pekeppp/xunjicar-speed45/6a52b6358da415270c09f10d88b06ae2.jpg

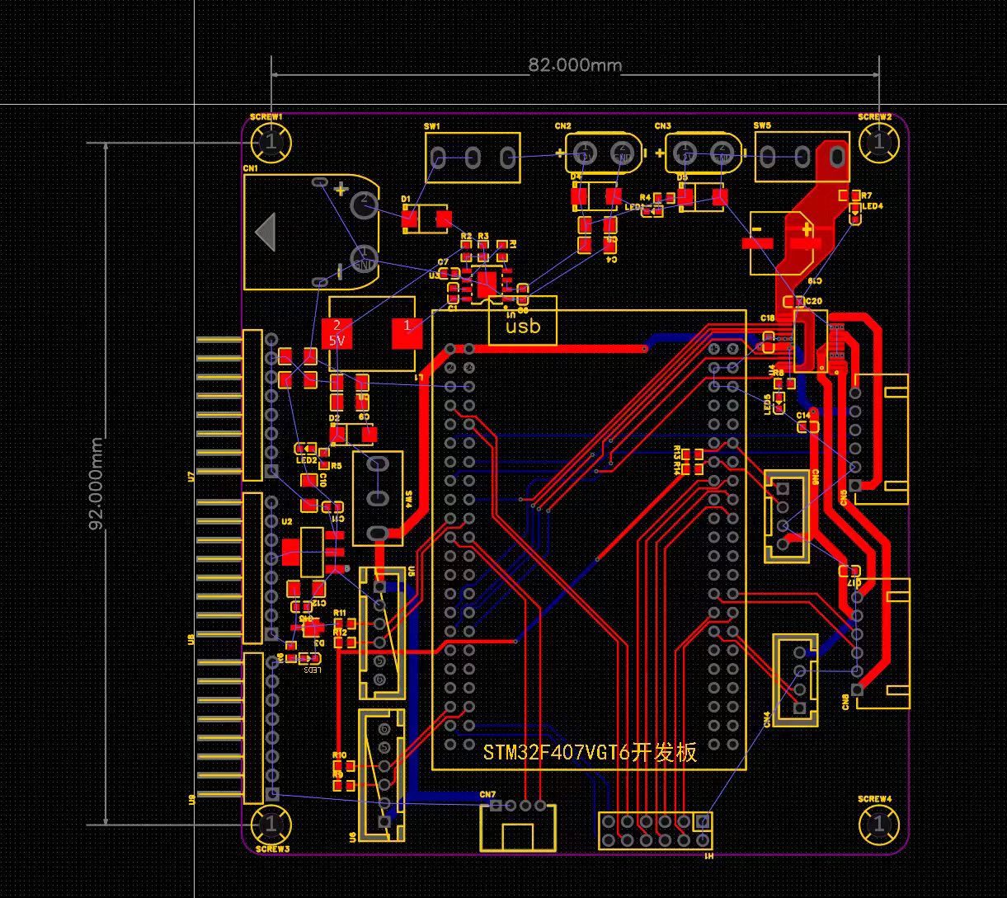
6a52b6358da415270c09f10d88b06ae2.jpg
