pekeppp/xunjicar-speed45/烧录工具与路径说明.md

# 烧录工具与路径说明

> 回答一个问题：**"正常烧录不都要用专门的 programmer 软件吗？这里到底调了哪个软件？什么路径？怎么烧进去的？"**

---

## 一、最核心的一句话

**这里用的 programmer 软件就是 OpenOCD。**

它就是一个正规的、开源的烧录/调试软件（和 STM32CubeProgrammer、Keil 的 Download 按钮是同一类东西），
只是它没有图形界面，靠命令行参数干活。**不是"没有 programmer"，而是"programmer 是命令行版的"。**

```
你双击 3-烧录固件.cmd
        ↓
  3-烧录固件.cmd
        ↓  调用
  tools\flash.ps1                     ← 组装参数的"胶水"脚本
        ↓  调用
  C:\Users\darre\.platformio\packages\tool-openocd\bin\openocd.exe   ★ 真正的 programmer
        ↓  USB 通信
  ST-Link V2 硬件
        ↓  SWD 两根线（SWCLK / SWDIO）
  STM32F407 芯片内部 Flash
```

---

## 二、软件路径：它是怎么被找到的

`tools\flash.ps1` 第 42~71 行，按 **3 个优先级** 找 OpenOCD：

| 优先级 | 查找位置 | 本机结果 |
|---|---|---|
| 1 | 系统 `PATH` 环境变量里的 `openocd` | 没找到 |
| 2 | `C:\Users\darre\.platformio\packages\tool-openocd\`（递归搜 `openocd.exe`） | ✅ **命中** |
| 3 | `C:\Users\darre\AppData\Local\stm32cube\bundles\openocd\` | 没装 |

**本机实际使用的路径：**

```
可执行文件：C:\Users\darre\.platformio\packages\tool-openocd\bin\openocd.exe
脚本目录　：C:\Users\darre\.platformio\packages\tool-openocd\openocd\scripts\
版本　　　：xPack Open On-Chip Debugger 0.12.0+dev-02228-ge5888bda3-dirty
```

脚本目录也是**每一层往上找**出来的（第 60~71 行）：从 `openocd.exe` 所在目录开始往上爬最多 4 层，
看哪层存在 `openocd\scripts\target\stm32f4x.cfg` 或 `scripts\target\stm32f4x.cfg`。

> 这两个文件夹都在 **你的用户目录**下，不在工程里，也不在 C 盘全局。
> 所以换一台电脑，要么重装这两个包，要么把整个 `.platformio` 文件夹拷过去。

---

## 三、真正执行的命令（逐字拆解）

`flash.ps1` 最终拼出来的命令行就是这一条：

```powershell
& "C:\Users\darre\.platformio\packages\tool-openocd\bin\openocd.exe" `
  -s "C:\Users\darre\.platformio\packages\tool-openocd\openocd\scripts" `
  -f interface/stlink.cfg `
  -f target/stm32f4x.cfg `
  -c "adapter speed 1000" `
  -c "program C:/Users/darre/Desktop/competition/xunjicar/xunjicar/XunjiCar/XunjiCar/build/out/XunjiCar.hex verify reset exit"
```

### 每个参数干什么

| 参数 | 含义 | 对应代码行 |
|---|---|---|
| `-s <目录>` | 告诉 OpenOCD 去哪找 `.cfg` 配置文件 | `flash.ps1:96` |
| `-f interface/stlink.cfg` | **用哪种调试器**：ST-Link（里面写死了 USB VID/PID `0x0483:0x3748` 等一长串，插上是哪个型号自动认） | `flash.ps1:97` |
| `-f target/stm32f4x.cfg` | **目标芯片是谁**：STM32F4 系列（声明 flash bank、期望 IDCODE `0x2ba01477`、借 SRAM `0x20000000` 32KB 当 work area） | `flash.ps1:98` |
| `-c "adapter speed 1000"` | SWD 时钟 1000 kHz。**它是运行时覆盖** —— `stm32f4x.cfg` 里默认写的是 2000，加 `-Speed 500` 就变成 500 | `flash.ps1:99` |
| `-c "program … verify reset exit"` | 核心动作：烧 → 校验 → 复位 → 退出 | `flash.ps1:108` |

### 三个模式的区别（第 102~110 行）

```powershell
# 默认（3-烧录固件.cmd）：直接烧
-c "program <hex> verify reset exit"

# -Check（2-检查STLink连接.cmd）：只连接，认出芯片就退出，不写任何东西
-c "init" -c "targets" -c "exit"

# -Erase：先全片擦除再烧
-c "init" -c "reset halt" -c "stm32f4x mass_erase 0"
-c "program <hex> verify reset exit"
```

### 烧哪个文件（第 28 行）

默认烧 `XunjiCar\XunjiCar\build\out\XunjiCar.hex`。
第 90 行有一个关键细节：**把路径里的 `\` 全部换成 `/`** ——
因为 OpenOCD 内部是 Tcl 解释器，反斜杠在 Tcl 里是转义符，带 `\` 的 Windows 路径会被吃掉。

---

## 四、为什么不用 STM32CubeProgrammer / Keil 也能烧

这是最容易困惑的地方。答案是：

> **烧 Flash 这件事，标准做法不止一种。任何能说 SWD 协议的程序都能烧，CubeProgrammer 只是 ST 官方做的一个。**

OpenOCD 自带 **ST-Link 驱动**（`interface/stlink.cfg` 里第一句 `adapter driver st-link`），
它通过 **libusb/WinUSB 直接和 ST-Link 硬件对话**，完全绕开 ST 的驱动和软件栈。

| 方案 | 谁做的 | 要不要装 | 本项目 |
|---|---|---|---|
| **OpenOCD** | 开源社区（xPack 打包） | 一个文件夹，解压即用 | ✅ **在用** |
| STM32CubeProgrammer | ST 官方，带图形界面 | 要装，几百 MB | ❌ 本机没装 |
| Keil MDK 的 Download | Keil 内置 | 要装 Keil + 建工程 | ❌ 用不上（本工程没有 .uvprojx） |
| pyocd | ARM 开源 | `pip install pyocd` | ❌ 手册 §13 有一处提到它，是早期写法，**现在不用了** |

---

## 五、OpenOCD 到底怎么把数据写进 Flash 的

**关键点：写入动作不是 OpenOCD 干的，是 STM32 自己干的。**

```
1. OpenOCD halt 内核
      ↓ 通过 SWD 读写调试寄存器（DHCSR），让 Cortex-M4 停止取指

2. OpenOCD 擦除目标扇区
      ↓ 通过 AHB-AP 直接操作 Flash 控制器寄存器（FLASH_KEYR / FLASH_CR / FLASH_SR）

3. OpenOCD 把一段"Flash 编程算法"下载到 SRAM 0x20000000
      ↓ 这就是 target/stm32f4x.cfg 里 -work-area-phys 0x20000000 -work-area-size 0x8000 的用途

4. 让内核执行这段算法，算法自己去逐字写 Flash 并等 FLASH_SR.BSY 清零
      ↓ （STM32F4 内部 Flash 只能 1→0，所以必须先擦成 0xFF 再写）

5. OpenOCD 回读比对 → 打印 ** Verified OK **
      ↓ flash.ps1 第 134 行就是靠 grep 这个字符串判断成功的

6. reset：释放复位，内核从 0x08000000 重新取指
      ↓ [0x08000000] = 栈顶 MSP，[0x08000004] = Reset_Handler
      ↓ Reset_Handler 设 SP、拷 .data、清 .bss、进 main()
```

芯片地址布局来自链接脚本 `STM32F407VGTx_FLASH.ld`：

| 区域 | 起始地址 | 大小 |
|---|---|---|
| FLASH | `0x08000000` | 1024 KB |
| RAM | `0x20000000` | 128 KB |
| CCMRAM | `0x10000000` | 64 KB |

`XunjiCar.hex` 第一行就能验证这套约定：

```
:020000040800F2              ← 扩展线性地址 = 0x0800（基址 0x08000000）
:100000000000022071750008…   ← 前 4 字节 0x20020000 = 栈顶
                                后 4 字节 0x08007571 = Reset_Handler 地址
:040000050800757109          ← 入口点 = 0x08007571
```

---

## 六、为什么这 4 根线就够了

ST-Link 是个 **USB ↔ SWD 协议转换器**，它自己不是 programmer，只是个"翻译官"：

| ST-Link | 开发板 | 作用 |
|---|---|---|
| SWDIO | PA13 | 双向数据线（板上丝印可能写 `DIO`） |
| SWCLK | PA14 | 时钟线（板上丝印可能写 `CLK`） |
| GND | GND | **必须共地**，否则什么都收不到 |
| 3.3V | 3V3 | 电平参考（VTref），ST-Link 靠它确认目标电压；**不是给板子供电** |

**PA13/PA14 是芯片的 SWD 复用功能，上电默认就是 SWD 模式，且工程代码从没把它们配成普通 IO，所以永远可用。**

> ⚠️ 板上那组排针丝印是 `BT0 3V3 GND DIO CLK`。
> **BT0 = BOOT0，一根线都不要接！** 拉高会进 ST 出厂 Bootloader，你烧的程序就不跑了。

---

## 七、换个软件/换台电脑怎么办

### 换成别的 programmer

```powershell
# 用 STM32CubeProgrammer（本机没装）
STM32_Programmer_CLI.exe -c port=SWD -w XunjiCar.hex -v -rst

# 用 pyocd
pyocd flash -t stm32f407vetx XunjiCar.hex

# 用 Keil：需要先建工程，不推荐
```

注意 `XunjiCar.bin` 是**纯二进制、不带地址**，给串口 ISP 用时必须由工具手动指定起始地址 `0x08000000`；
`XunjiCar.hex` 自带地址字段，随便哪个工具都能直接用。

### 换台电脑要装什么

```powershell
# 1) ARM 编译器（约 200 MB）
python -m platformio pkg install --global --tool platformio/toolchain-gccarmnoneeabi

# 2) OpenOCD（就是本项目的 programmer）
python -m platformio pkg install --global --tool platformio/tool-openocd

# 3) 看数据的串口脚本需要 Python 3
python --version
```

装完先验证：

```powershell
# 应该打印 0.12.0 之类的版本号
C:\Users\<你的用户名>\.platformio\packages\tool-openocd\bin\openocd.exe --version
```

### 也可以不用脚本、手敲原生命令

```powershell
$ocd = "$env:USERPROFILE\.platformio\packages\tool-openocd\bin\openocd.exe"
$sc  = "$env:USERPROFILE\.platformio\packages\tool-openocd\openocd\scripts"

# 只连接、认芯片、列目标
& $ocd -s $sc -f interface/stlink.cfg -f target/stm32f4x.cfg -c "adapter speed 1000" -c "init" -c "targets" -c "exit"

# 真正烧录（路径记得用正斜杠）
& $ocd -s $sc -f interface/stlink.cfg -f target/stm32f4x.cfg -c "adapter speed 1000" `
       -c "program C:/Users/darre/Desktop/competition/xunjicar/xunjicar/XunjiCar/XunjiCar/build/out/XunjiCar.hex verify reset exit"
```

---

## 八、路径/工具相关故障速查

| 报错 | 真实原因 | 处理 |
|---|---|---|
| `没找到 OpenOCD` | 上面 3 个查找位置都没命中 | 跑一遍 `python -m platformio pkg install --global --tool platformio/tool-openocd` |
| `找到 OpenOCD 但没找到脚本目录` | `openocd.exe` 找到了但同包的 `scripts\` 丢了 | 重装 `tool-openocd` 包（别只拷 exe） |
| `找不到固件: …XunjiCar.hex` | 还没编译 | 先跑 `1-编译固件.cmd` / `tools\build.ps1` |
| `Error: open failed` | 没认到 ST-Link 硬件 | 换 USB 口；设备管理器确认有 `STLink` 且状态 OK |
| `Error: init mode failed` | 芯片没供电 / SWD 接错 / 线太长 | 板子自己上电；检查 PA13/PA14；降速 `-Speed 500` |
| target not halted | 调试口被别的软件占了 | 关掉 Keil / CubeIDE / CubeProgrammer / 残留的 `openocd.exe` 进程 |
| 写入报错 | 芯片读保护 | 加 `-Erase` 全片擦除后重烧 |
| 烧完没反应 | BT0 被短到 3V3，或没重新上电 | 拔掉 BT0 上的线；拔插一次电源或按复位 |
| **双击 `.cmd` 一闪而过 / 满屏 `'xxx' 不是内部或外部命令`、`系统找不到指定的路径`、`'ershell' 不是内部或外部命令`** | **`.cmd` 被存成了 LF 换行**。cmd.exe 解析 GBK 批处理时按字节数定位行，LF 会让它错行：中文行被整行吃掉、`cd /d "%~dp0"` 失效、`powershell` 前半截被吞（`pow` 没了 → 剩 `ershell`）。元凶是 `.gitattributes` 里全仓库生效的 `* text=auto eol=lf` | 把 `.cmd` 转回 **CRLF + GBK(936) + 无 BOM**；`.gitattributes` 里已有 `*.cmd text eol=crlf` 兜底。一键修复见第十节 |

---

## 九、一页速记

```
programmer 软件 = OpenOCD（命令行版，无图形界面）
路径            = C:\Users\darre\.platformio\packages\tool-openocd\bin\openocd.exe
配置文件目录    = C:\Users\darre\.platformio\packages\tool-openocd\openocd\scripts\
调用者          = tools\flash.ps1（组装命令行）← 3-烧录固件.cmd（双击入口）
固件            = XunjiCar\XunjiCar\build\out\XunjiCar.hex
核心命令        = openocd -f interface/stlink.cfg -f target/stm32f4x.cfg \
                          -c "adapter speed 1000" \
                          -c "program <hex> verify reset exit"
传输链路        = USB → ST-Link V2 → SWD(PA13/PA14) → Cortex-M4 调试口 → 芯片内部 Flash
写入原理        = OpenOCD 把 Flash 编程算法下载进 SRAM，让芯片自己去擦写自己的 Flash
成功标志        = OpenOCD 打印 ** Verified OK ** → 脚本输出"烧录成功，芯片已复位运行。"
```

---

## 十、`.cmd` 换行修复（万一又坏了）

上面那个"一闪而过"的故障根因只有一个：**`.cmd` 是 LF 换行**。
`cmd.exe` 读批处理时按字节数定位行，LF 会让它错行。**这个坑已经复发过一次**，
所以改完 `.cmd` 或从别处拷来工程后，务必跑一遍下面的自检。

在工程根目录执行这一条就能修好（GBK 读进来、CRLF 写回去，内容一个字不改）：

```powershell
$gbk = [System.Text.Encoding]::GetEncoding(936)
Get-ChildItem *.cmd | ForEach-Object {
    $t = $gbk.GetString([System.IO.File]::ReadAllBytes($_.FullName))
    $t = ($t -replace "`r`n","`n") -replace "`n","`r`n"
    [System.IO.File]::WriteAllBytes($_.FullName, $gbk.GetBytes($t))
}
```

自检这四项，缺一个就会坏：

```powershell
$gbk = [System.Text.Encoding]::GetEncoding(936)
Get-ChildItem *.cmd | ForEach-Object {
    $b = [System.IO.File]::ReadAllBytes($_.FullName)
    $s = $gbk.GetString($b)
    $crlf = ([regex]::Matches($s,"`r`n")).Count
    $lf   = ([regex]::Matches($s,"`n")).Count
    "{0}: BOM={1} CRLF={2} bareLF={3} chcp936={4}" -f `
        $_.Name, ($b[0] -eq 0xEF), $crlf, ($lf-$crlf), [bool]($s -match 'chcp 936')
}
```

**四条铁律**（`.cmd` 必须同时满足）：

| 要求 | 原因 |
|---|---|
| 换行 = **CRLF**（`0D 0A`） | LF 会让 cmd.exe 错行，中文行被吃掉 |
| 编码 = **GBK / CP936**，无 BOM | 本机控制台代码页是 936；有 BOM 时首行会变成 `锘?echo off` 报错 |
| 开头要有 `chcp 936 >nul` | 保证中文提示显示正常 |
| 路径不要带空格 | `tools\build.ps1` 的 `-I` 参数拼接不支持空格路径 |

`.gitattributes` 里的 `* text=auto eol=lf` 是**全仓库**生效的，
所以必须靠后面的 `*.cmd text eol=crlf` 显式盖回 CRLF —— 这两行顺序不能反。

---

## 十一、工程被移动/改名后要检查什么

`tools\build.ps1`、`tools\flash.ps1` 和 4 个 `.cmd` 全部用 `%~dp0` / `$MyInvocation` 定位，
**工程挪到哪都能用，不用改**。`.ioc`、`.mxproject`、`.clangd`、`CMakePresets.json`
也都是相对路径，同样不用改。

唯一写死绝对路径的是编辑器配置：

| 文件 | 内容 | 说明 |
|---|---|---|
| `.vscode/settings.json` | `cmake.sourceDirectory` | 已改成 `${workspaceFolder}/XunjiCar/XunjiCar`，**以后再挪也不会坏** |
| `XunjiCar\XunjiCar\.vscode\c_cpp_properties.json` | `${workspaceFolder}/build/Debug/...` | 本来就是相对路径，不用动 |

换路径后建议清一次旧的构建缓存（里面存着绝对路径）：

```powershell
powershell -ExecutionPolicy Bypass -File tools\build.ps1 -Clean
```

另外 `烧录工具与路径说明.md` 第八/九节里作为**示例**出现的 hex 全路径，
换位置后如果和实际不符，按新的工程根替换即可（`tools\flash.ps1` 运行时自己算路径，不受影响）。
