pekeppp/xunjicar-speed45/docs_引脚位置_LQFP100_全图.png

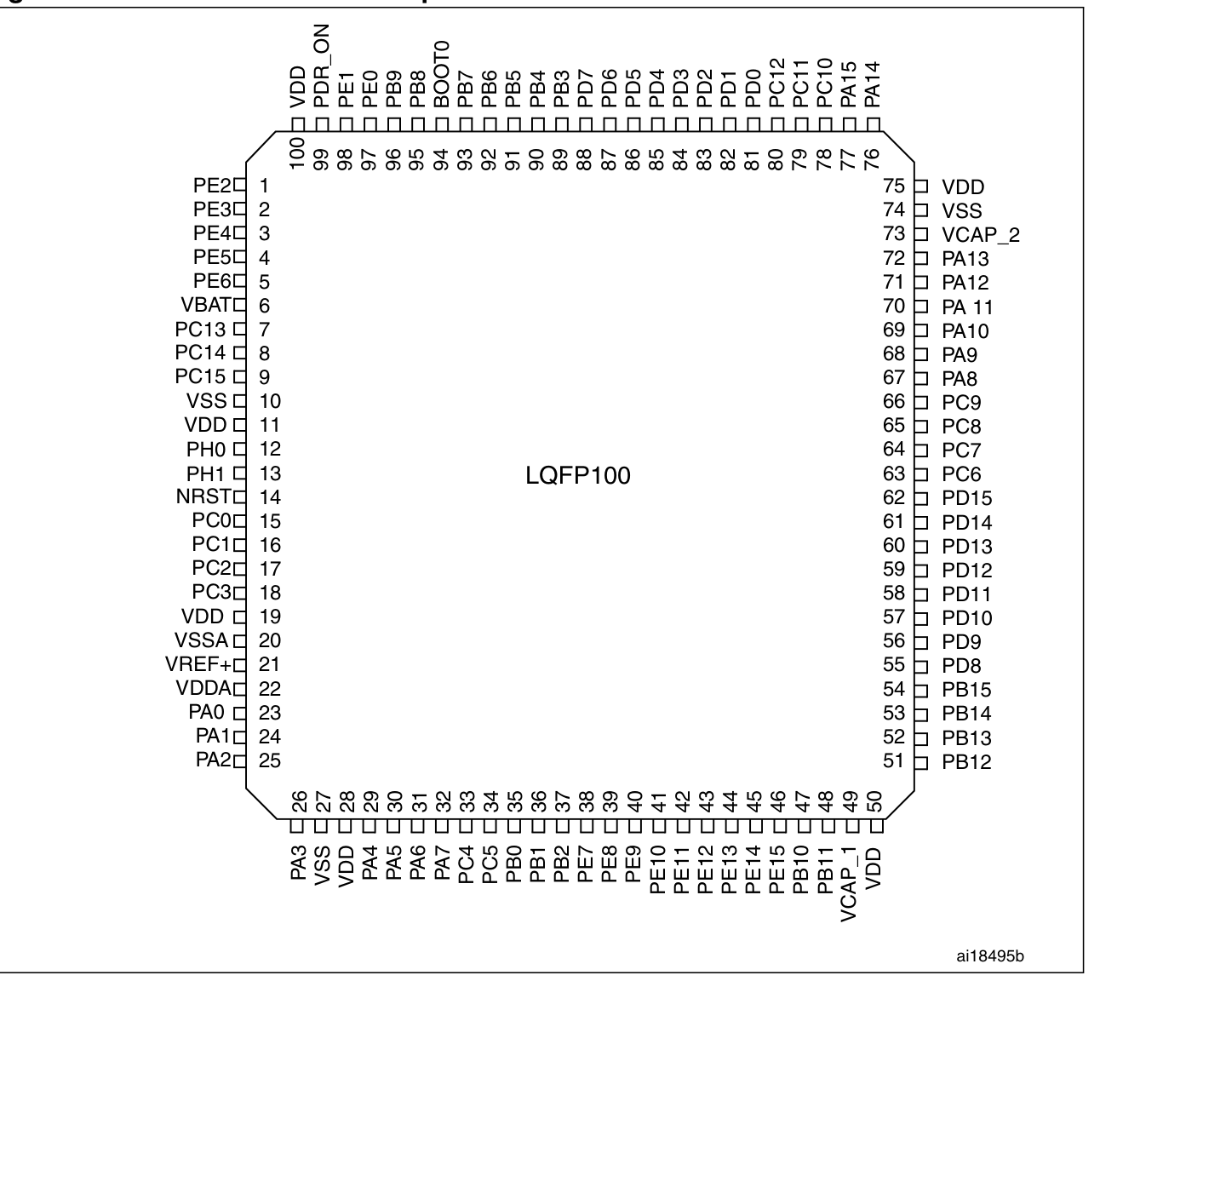
docs_引脚位置_LQFP100_全图.png
