pekeppp/xunjicar-speed45/docs_引脚位置_PA13_PA14_标注.png

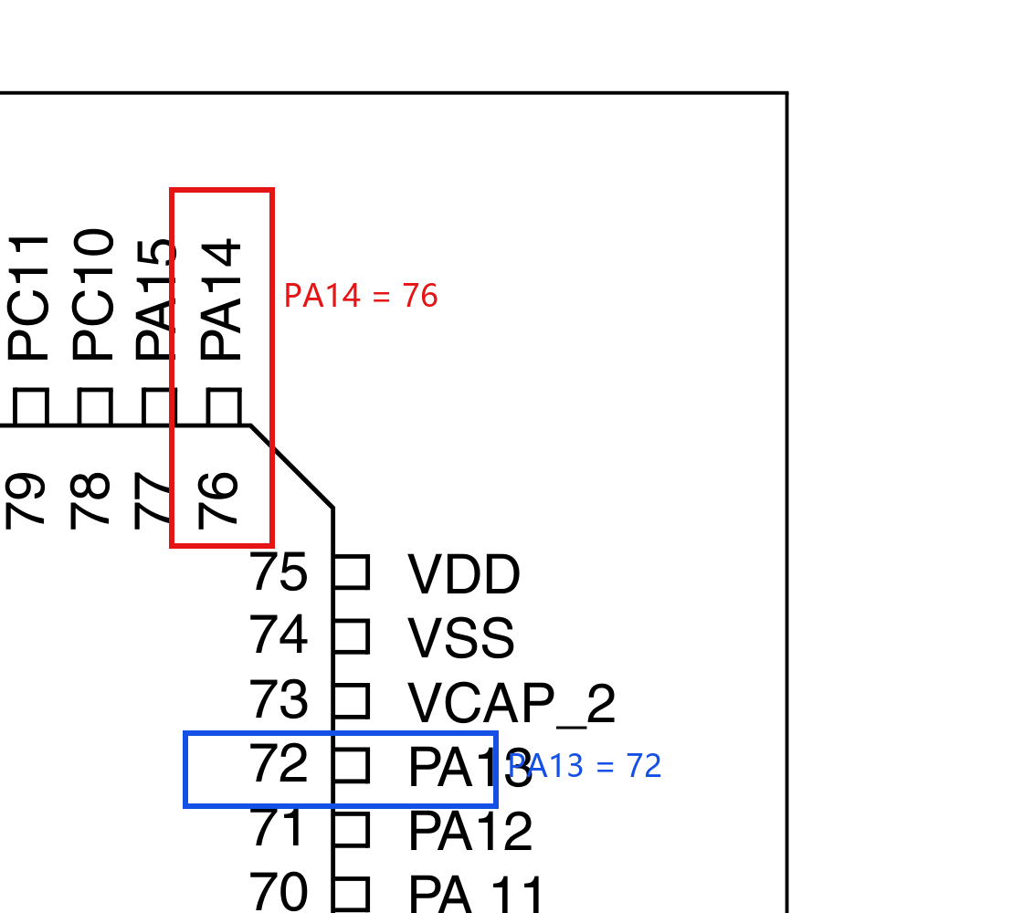
docs_引脚位置_PA13_PA14_标注.png
