pekeppp/xunjicar-speed45/直流电机—MG513XGMR编码器+支架（客户图）.stp

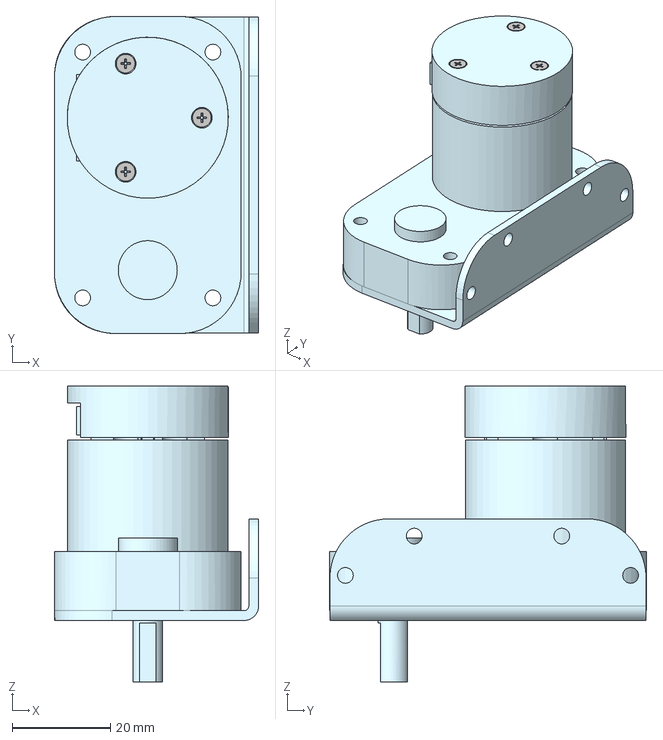
[picture p4: CAD file, 2026-09-30]
直流电机—MG513XGMR编码器+支架（客户图）.stp
41.6 x 64.5 x 60.2 mm
