pekeppp/xunjicar-speed45/直流电机—MG513XGMR编码器+支架+65mm轮子（客户图）.stp

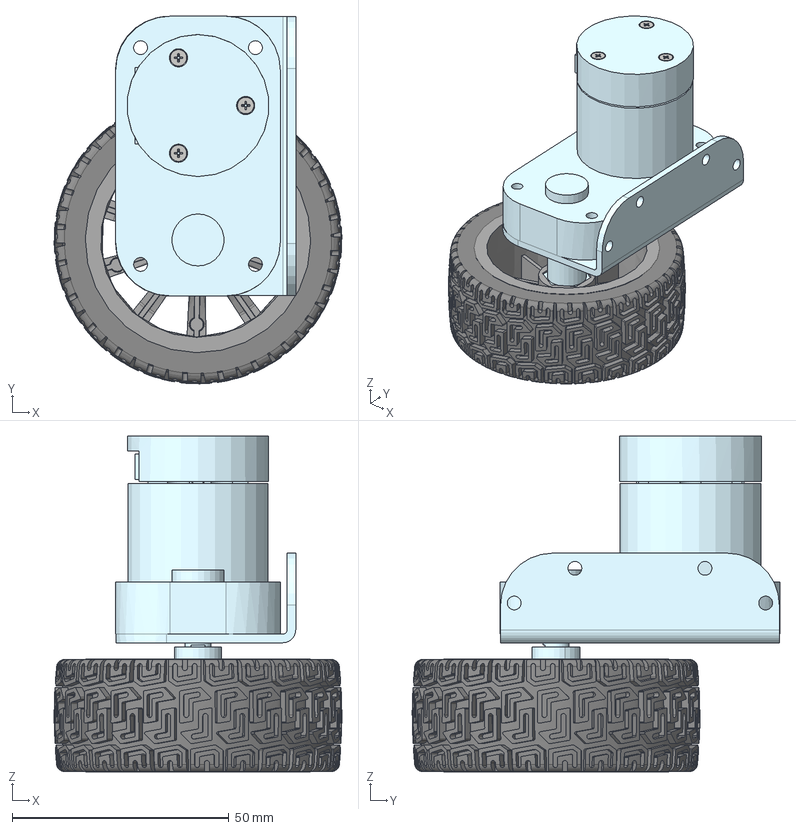
[picture p5: CAD file, 2026-09-30]
直流电机—MG513XGMR编码器+支架+65mm轮子（客户图）.stp
66.4 x 84.8 x 77.5 mm
