pekeppp/xunjicar-speed45/接线与调试手册.md

# 智能小车 接线与调试手册

> 适用硬件：**STM32F407VGT6 开发板（就是图 `6a52b635…jpg` 那块，82×92 mm）** + TB6612FNG 电机驱动
> + 2× MG513 GMR 编码器减速电机 + 8 路 UART 循迹模块 + MPU6050 + 2× VL53L0X
> 适用固件：本仓库 `XunjiCar` 工程（`$CAR` 遥测帧）
> **接线方式：所有模块的杜邦线直接插到这块开发板的长排针上 —— 板子本身就是接线中枢，不需要面包板或转接板。**
> 引脚电平核对结果见第 10 节。

---

## 1. 准备清单

### 硬件
| # | 东西 | 备注 |
|---|---|---|
| 1 | STM32F407 开发板 | 你已组装好的那块 |
| 2 | TB6612FNG 驱动模块 ×1 | 代码按它的引脚命名（AIN1/AIN2/BIN1/BIN2/PWMA/PWMB/STBY）写的 |
| 3 | MG513 编码器电机 ×2 | 6 芯线：M+/M- + VCC/GND/A/B |
| 4 | 8 路红外循迹模块（**串口版**）×1 | 若是 I2C 版或并口版，代码要改，先拍照告诉我 |
| 5 | MPU6050（GY-521）×1 | |
| 6 | VL53L0X 激光测距 ×2 | **必须是 L0X**；买到 VL53L1X 的话寄存器不兼容，代码要换 |
| 7 | USB-TTL 模块 ×1 | CH340 / CP2102 / FT232 都行，**必备**，否则看不到数据 |
| 8 | ST-Link V2 ×1（推荐） | 用 SWD 烧录，不占用 USART1 |
| 9 | 电池 | 2S 锂电 7.4V 或 6 节 AA 电池盒 9V，给电机用 |
| 10 | 5V 降压模块 ≥2A | 从电池转 5V 给逻辑（或暂时用充电宝） |
| 11 | 杜邦线、扎带、双面胶 | 母-母、公-母都备一些 |

---

## 2. 供电架构（先看懂这张图再动手）

```
        电池 7.4~12V（正极）
              │
      ┌───────┴────────────────────────┐
      │                                │
      ▼                                ▼
 TB6612  VM（电机电）            5V 降压模块（≥2A）
      │                                │
      ▼                                ├──> 开发板 5V 排针 ──(板载AMS1117)──> 3V3 排针
 左电机 M+/M-                          ├──> 循迹模块 VCC (5V)
 右电机 M+/M-                          └──> 两个编码器 VCC (5V)
                                            │
                                    3V3 排针 ├──> MPU6050 VCC
                                            └──> 2× VL53L0X VCC

 电池负极 = 总地（GND）：开发板 GND、TB6612 GND、循迹 GND、编码器 GND、
                        MPU6050 GND、两个 TOF GND、USB-TTL GND —— 全部连在一起
```

几个要点：
- 开发板上那颗 **AMS1117-3.3** 把 5V 转成 3.3V，所以 3V3 排针最多能带几百 mA，够传感器用。
- 暂时没有降压模块时：**逻辑部分先用 Micro USB / 充电宝供 5V**，电机另用电池，但两边 **GND 必须连一起**。这是最快能开始调试的做法。
- 板上左上角那个 DC 电源座，**不确定它内部有没有稳压的就别接电池**；要用先量一下它是不是直接并在 5V 上。

---

## 3. 引脚总表（所有线都插到这块板的长排针上）

> 板子长排针的丝印直接写着 `PA6` / `PC6` / `5V` / `3V3` / `GND`，对着丝印找即可。
> 万一丝印看不清，用第 12 节的"引脚定位三步法"（通断档 + 引脚扫描固件）确定，别猜。

### 3.0 先规划：88 个孔，哪根线插哪一边

既然整块板就是接线中枢，唯一要提前想清楚的是**信号分两边、电源集中取**，不然线会绕成一团、以后查线很痛苦。

**信号分组建议**（同一组插在同一侧，跟着对应模块走线）：

| 分组 | 涉及引脚 | 建议插在哪一侧 |
|---|---|---|
| 电机驱动（6 根信号） | PC6、PC7、PD0、PD1、PD2、PD3 | 靠 TB6612 的那一侧 |
| 编码器（4 根信号） | PA6、PA7、PD12、PD13 | 同上（跟着电机线束走） |
| 循迹模块串口（2 根） | PA9、PA10 | 靠车头/循迹模块的那一侧 |
| I2C 传感器（6 根） | PB6、PB7、PB10、PB11、PA8、PC9 | 靠传感器集中放置的那一侧 |
| 上位机串口（2 根） | PA2、PA3 | 靠 USB-TTL 固定位置那一侧 |
| 烧录（2 根） | PA13、PA14 | 固定不动，留出插 ST-Link 的空间 |

**电源怎么分配**（每个模块都要 5V 或 3V3 + GND，但排针上的电源孔只有几个）：

1. **推荐**：若第 0.5 节测出 CH2 或 CH3 是 5V 输出，就把它当 **5V 母线** —— 用一根线从排针 5V 引到端子，三个 5V 负载（循迹模块、两个编码器）直接拧在端子上；
2. 或者用**一分二 / 一分三杜邦线**从一个 5V 孔分出去；
3. 或者把 5V/GND 引到一小段电源分配条/面包板电源条上；
4. **3V3 只带 MPU6050 + 两个 VL53L0X**（三个加起来约 40~60 mA，板载稳压带得动），不要再往上加负载。
5. **不要"借孔"**：信号线绝不插到相邻的电源孔上 —— 2.54 mm 间距很近，插错一格就是电源进 IO。

**电流预算**（估算，逻辑部分超了会掉电复位）：

| 负载 | 电流 | 取电 |
|---|---|---|
| 开发板本体 | 60~120 mA | 5V |
| MPU6050 | ~4 mA | 3.3V |
| VL53L0X ×2 | 各 ~20 mA（测量瞬间更高） | 3.3V |
| 8 路循迹模块 | 30~100 mA | 5V |
| 编码器 ×2 | 各 ~20 mA | 5V |
| **逻辑合计** | **约 200~300 mA** | 板载 5V/3.3V 够用 |
| 电机 ×2 | 空载各 ~200 mA，**堵转可达 1~2 A** | **必须走 TB6612 VM + 电池，绝不走板子** |

### 3.1 TB6612FNG（电机驱动）

| TB6612 引脚 | 接到 | 说明 |
|---|---|---|
| VM | 电池正极（7.4~12V） | 电机电，**不要接 5V/3V3** |
| VCC | 开发板 **3V3** | 逻辑电；接 3.3V 可以和单片机电平完全匹配，最稳 |
| GND | 总地 GND | 还必须与电池负极相连 |
| STBY | 开发板 **3V3**（长接高） | 低电平=电机全部不转。代码假设它一直为高 |
| PWMA | **PC6**（TIM8_CH1） | 左电机调速，20 kHz |
| AIN1 | **PD0** | 左电机方向 1 |
| AIN2 | **PD1** | 左电机方向 2 |
| PWMB | **PC7**（TIM8_CH2） | 右电机调速 |
| BIN1 | **PD2** | 右电机方向 1 |
| BIN2 | **PD3** | 右电机方向 2 |
| AO1 / AO2 | 左电机两根线（M+/M-） | 接反只是转向反，不会烧 |
| BO1 / BO2 | 右电机两根线 | 同上 |

### 3.2 编码器（跟着电机一起来的那 4 根信号线）

| 编码器 | 接到 | 说明 |
|---|---|---|
| 左电机 VCC | **5V** | 也可接 3V3，A/B 脚都是 5V 容忍的，两种都安全 |
| 左电机 GND | 总地 | |
| 左电机 A 相 | **PA6**（TIM3_CH1） | |
| 左电机 B 相 | **PA7**（TIM3_CH2） | |
| 右电机 VCC | **5V** | |
| 右电机 GND | 总地 | |
| 右电机 A 相 | **PD12**（TIM4_CH1） | |
| 右电机 B 相 | **PD13**（TIM4_CH2） | |

### 3.3 8 路循迹模块（串口版）

| 模块引脚 | 接到 | 说明 |
|---|---|---|
| VCC | **5V** | |
| GND | 总地 | |
| TX | **PA10**（USART1_RX） | 模块发、单片机收 → **交叉接** |
| RX | **PA9**（USART1_TX） | 单片机发配置命令给模块用 |

协议：115200 8N1；单片机发 `$0,0,1#` 让它只输出数字型数据，模块回
`$D,x1:0,x2:0,...,x8:0#`，代码已经写好了。

### 3.4 MPU6050

| 模块引脚 | 接到 |
|---|---|
| VCC | **3V3**（GY-521 板载稳压，接 5V 也行，但 3V3 更稳） |
| GND | 总地 |
| SCL | **PB10**（I2C2_SCL） |
| SDA | **PB11**（I2C2_SDA） |
| AD0 | **GND**（地址 = 0x68，和代码一致） |
| INT | 不接 |

### 3.5 两个 VL53L0X

| | 1 号（左） | 2 号（右） |
|---|---|---|
| VCC | **3V3** | **3V3** |
| GND | 总地 | 总地 |
| SCL | **PB6**（I2C1_SCL） | **PA8**（I2C3_SCL） |
| SDA | **PB7**（I2C1_SDA） | **PC9**（I2C3_SDA） |
| XSHUT | 不接 | 不接 |

> 两个 VL53L0X 出厂地址都是 0x29，**必须挂在两条不同的 I2C 总线上**，这就是代码用 I2C1 + I2C3 的原因。
> 如果模块上 XSHUT 是裸的、读不到数据，再把 XSHUT 接 3V3 试试。

### 3.6 电脑通信（USB-TTL）

| USB-TTL | 接到 | 说明 |
|---|---|---|
| RXD | **PA2**（USART2_TX） | 板子发、电脑收 |
| TXD | **PA3**（USART2_RX） | 电脑发、板子收 |
| GND | 总地 | **必须接**，否则乱码 |
| VCC / 5V | **不接** | 别让 USB-TTL 给板子供电，避免双电源打架 |

### 3.7 烧录（ST-Link，推荐）

| ST-Link | 开发板 |
|---|---|
| SWDIO | **PA13** |
| SWCLK | **PA14** |
| GND | GND |
| 3.3V | 3V3（可接可不接，板子自己供电时不用接） |

## 8. 代码里需要按实车改的参数

> 调车 90% 的时间只改 **`Core/Inc/line_follow.h`** 这一个文件。

### 8.1 循迹与避障（`Core/Inc/line_follow.h`）—— 最常改

| 宏 | 作用 | 什么时候改 |
|---|---|---|
| `LF_BASE_DUTY` | 直道基础速度 % | 车太慢/太快 |
| `LF_KP` | 比例：修正力度 | 过弯冲出去 → 加大；直道来回摆 → 减小 |
| `LF_KD` | 微分：压摆动 | 摆得厉害 → 加大 |
| `LF_KI` | 积分 | 一般保持 0 |
| `LF_STEER_LIMIT` | 差速上限 % | 快 90° 急弯转不过来 → 加大；修正太猛/直道一顿一顿 → 减小 |
| `LF_BLACK_IS_ZERO` | 探头极性 | 车往白的地方跑 → 改成 0 |
| `LF_LOST_ACTION` | 丢线后停车(0)/原地找线(1)/陀螺仪保持航向(2) | 调参阶段用 0，比赛可选 2 |
| `LF_LOST_TIMEOUT_MS` | 丢线容忍时间 | 虚线/断线误判 → 加大 |
| `LF_STOP_DISTANCE_MM` | 避障停车距离 mm | 不需要避障就填 0 |
| `LF_RESUME_DISTANCE_MM` | 障碍离开后恢复距离 | 停车后一顿一顿 → 加大 |
| `LF_USE_FRONT_TOF` | 用哪路 TOF 当前方 | 0=D1, 1=D2, 2=两路取最近 |
| `LF_USE_IMU` | 是否用陀螺仪做阻尼 | 不想用就改 0（没接 MPU 会自动失效） |
| `LF_KGYRO` | 陀螺仪阻尼力度 (0.01%/dps) | 画龙 → 加大；发抖发木 → 减小 |
| `LF_GYRO_SIGN` | 陀螺仪方向 | 左转时 `角速度` 为负 → 改 -1 |
| `LF_KHOLD` | 丢线保持航向的力度 (0.1%/度) | 只有 `LF_LOST_ACTION=2` 时有用 |
| `LF_LOST_HOLD_MS` | 丢线后最多直行找线多久 | 同上 |
| `LF_AUTO_START` | 上电自动开始 | 想用按钮启动就改 0 |
| `LF_START_DELAY_MS` | 上电后等多久开始 | 给你放车的时间 |

### 8.2 其他文件

| 文件 | 宏 | 什么时候改 |
|---|---|---|
| `Core/Inc/motor_test.h` | `MOTOR_TEST_AUTO_RUN` | 默认 0；要单测电机接线时改 1 |
| `Core/Inc/motor_test.h` | `MOTOR_ENC_PPR` / `MOTOR_GEAR_RATIO` | 手转一圈标定出的计数不对时 |
| `Core/Inc/motor_test.h` | `MOTOR_A/B_ENC_INVERT` | 正转时 `EA` 为负 → 改 `1` |
| `Core/Inc/track_uart.h` | `TRACK_DATA_WHITE_IS_ONE` | 黑白极性与代码假设相反 → 改 `0u` |
| `Core/Inc/line_follow.h` | `LF_ENABLE_TOF_LASER` | 激光测距/避障总开关，**默认 `(0)` 关**；要用激光避障才改 `(1)` |
| `Core/Inc/line_follow.h` | `LF_STOP_DISTANCE_MM` / `LF_RESUME_DISTANCE_MM` / `LF_USE_FRONT_TOF` | 只有 `LF_ENABLE_TOF_LASER=1` 时才生效 |
| `Core/Inc/telemetry.h` | `TELEMETRY_TOF_COUNT` | 只用一路 TOF 时改 `1u` |
| `Core/Inc/mpu6050.h` | `MPU6050_ADDR7` | AD0 接 3.3V 时改 `0x69u` |
| `Core/Inc/vl53l0x.h` | `VL53L0X_MEASUREMENT_BUDGET_US` | 测距要更准(加大)/更快(减小) |
| `Core/Src/main.c` | 循迹模块校准三行 | 校准时取消注释，校完再注掉 |

---

## 9. 上位机工具

```powershell
# 列出串口
python tools\telemetry_monitor.py --list

# 实时监视（推荐先用这个把接线一步步验完）
python tools\telemetry_monitor.py --port COM5

# 同时存 CSV（Excel 可直接打开，用来画曲线/标定）
python tools\telemetry_monitor.py --port COM5 --csv run1.csv

# 只跑 10 秒
python tools\telemetry_monitor.py --port COM5 --duration 10

# 排查波特率/接线时把坏帧也打出来
python tools\telemetry_monitor.py --port COM5 --show-bad

# 没有硬件也能自检脚本是否可用
python tools\telemetry_monitor.py --selftest
```

它会做这些事：校验帧尾 XOR 校验和 → 把 8 路循迹画成 `█`（压线）/`·`（白底）条形图 → 显示两路距离、姿态、电机状态和编码器增量 → 每 5 秒报一次帧率 → 第一次遇到 `TRK=ERR` / `D1=NA` / `IMU=NA` 时直接打印对应的接线排查提示。

依赖：`python -m pip install pyserial`（本机已装好）。

---

## 10. 附录：为什么这些引脚可以直连（已核对）

我把你用到的每一个引脚都在工作区那份《STM32F407VET6数据手册》里查了 I/O 结构（Table 6）：

| 引脚 | 用途 | I/O 结构 |
|---|---|---|
| PA2 / PA3 | USART2 → 上位机 | **FT（5V 容忍）** |
| PA6 / PA7 | 左编码器 TIM3_CH1/CH2 | **FT（5V 容忍）** |
| PA8 / PC9 | I2C3 → TOF2 | **FT（5V 容忍）** |
| PA9 / PA10 | USART1 → 循迹模块 | **FT（5V 容忍）** |
| PB6 / PB7 | I2C1 → TOF1 | **FT（5V 容忍）** |
| PB10 / PB11 | I2C2 → MPU6050 | **FT（5V 容忍）** |
| PC6 / PC7 | TIM8_CH1/CH2 → PWMA/PWMB | **FT（5V 容忍）** |
| PD0 ~ PD3 | 方向脚 AIN1/AIN2/BIN1/BIN2 | **FT（5V 容忍）** |
| PD12 / PD13 | 右编码器 TIM4_CH1/CH2 | **FT（5V 容忍）** |
| PA13 / PA14 | SWD 调试 | FT |

**结论**：5V 的循迹模块 TX、5V 供电的编码器 A/B 相都可以**直接接**，不需要分压电阻或电平转换模块。
（注：`motor_test.h` 里原来那句"PA6/PA7 可能是 TTa 需要分压"是当时的猜测，已按数据手册更正——本芯片上 PA4/PA5 才是 TTa 3.3V-only，PA6/PA7 是 FT。）

另外两点关于这块板子本身的核对结果（来自核心板原理图）：
- 板载稳压是 **AMS1117-3.3**（5V → 3.3V）；Micro USB 进来的 5V 经过一个 **L1（500 mA）** 保险/磁珠，所以**用 USB 供电时 5V 排针总电流别超过约 500 mA**，传感器够用，电机绝对不行。
- 原理图标的 MCU 是 **STM32F407VET6**（512 KB Flash），而 CubeMX 工程按 **VGTx**（1 MB）配置。两者都是 LQFP100、引脚完全一样，代码直接能跑，只是别把 Flash 用到超过 512 KB。

---

## 11. 下一步（接线验证完之后）

1. ✅ 循迹控制环（加权位置 + PD 差速）—— **已完成**，见 `Core/Src/line_follow.c`
2. ✅ 激光避障停车（带迟滞恢复）—— **代码已完成**，参数在 `line_follow.h`；
   总开关 `LF_ENABLE_TOF_LASER` **默认关**（要启用见第 15 节开头）
3. ⬜ 按第 14 节把 `LF_BASE_DUTY / LF_KP / LF_KD` 调到你能接受的手感
4. ⬜ 用编码器做**速度闭环**（`EA/EB` → 每 100 ms 计数 → 转速），让直道速度不随电池电压变化
5. ⬜ 路口/十字决策（现在八路全黑是按直行处理的）
6. ⬜ 用 MPU6050 的 `GZ` 做转弯辅助（比如直角弯时锁定航向）

---

## 12. 附：怎么在这块板上确定"哪个孔是 PA6"（没有图纸也能查）

### 12.0 数据手册里每个引脚的确切位置（LQFP100）

出处：`STM32F407VET6数据手册.pdf` **第 39 页 Figure 11「STM32F40x LQFP100 pinout」**，以及 Table 6（第 46~55 页）的引脚定义表。
我把图裁出来做了标注，直接看这两张图最清楚：

- `docs_引脚位置_LQFP100_全图标注.png` —— 全图，标出了第 1 脚、PA13、PA14
- `docs_引脚位置_PA13_PA14_标注.png` —— 右上角放大，PA13/PA14 圈出来了

**编号规则（视图方向 = 芯片正面朝上、引脚朝下）：**

```
        76(PA14) 77 78 ... 100(VDD)          ← 上边一行：从右往左 76→100
    ┌──────────────────────────────┐
 1  │                              │  75 VDD
PE2 │                              │  74 VSS
 ↓  │          STM32F4             │  73 VCAP_2
    │          LQFP100             │  72 PA13  ★
 25 │                              │  71 PA12
PA2 │                              │   ↓ 一直数到 51
    └──────────────────────────────┘
      26(PA3) 27 28 ... 50            ← 下边一行：从左往右 26→50
```

- **第 1 脚 = PE2，在左上角**（封装上有个小圆点/倒角做标记）
- 编号**逆时针**：左边 1→25 从上往下；下边 26→50 从左往右；右边 51→75 从下往上；上边 76→100 从右往左
- **★ PA13 = 第 72 脚**：右边那一列，**从上往下数第 4 个**（上面依次是 73=VCAP_2、74=VSS、75=VDD）
- **★ PA14 = 第 76 脚**：**上边那一行最右边的一个**，紧挨右上角

**你用到的全部引脚位置（对着上图和 Table 6 核过）：**

| 信号 | 脚号 | 在芯片上的位置 |
|---|---|---|
| PA2 (TX2) | 25 | 左边一列最下面（左下角） |
| PA3 (RX2) | 26 | 下边一行最左边（左下角） |
| PA6 | 31 | 下边一行，从左数第 6 个 |
| PA7 | 32 | 下边一行，第 7 个 |
| PB10 | 47 | 下边一行，从右数第 4 个 |
| PB11 | 48 | 下边一行，从右数第 3 个 |
| PD12 | 59 | 右边一列，从下往上第 9 个 |
| PD13 | 60 | 右边一列，第 10 个 |
| PD14 | 61 | 右边一列，第 11 个 |
| PD15 | 62 | 右边一列，第 12 个 |
| PC6 | 63 | 右边一列，第 13 个 |
| PC7 | 64 | 右边一列，第 14 个 |
| PC9 | 66 | 右边一列，第 16 个 |
| PA8 | 67 | 右边一列，第 17 个 |
| PA9 (TX1) | 68 | 右边一列，第 18 个 |
| PA10 (RX1) | 69 | 右边一列，第 19 个 |
| **PA13 (SWDIO)** | **72** | **右边一列，从上往下第 4 个** ★ |
| **PA14 (SWCLK)** | **76** | **上边一行最右边（右上角）** ★ |
| PD0 | 81 | 上边一行，从右数第 6 个 |
| PD1 | 82 | 上边一行，从右数第 7 个 |
| PD2 | 83 | 上边一行，从右数第 8 个 |
| PD3 | 84 | 上边一行，从右数第 9 个 |
| PB6 | 92 | 上边一行，从右数第 17 个 |
| PB7 | 93 | 上边一行，从右数第 18 个 |

> **实用建议**：LQFP100 引脚间距只有 0.5 mm，表笔很难点准，**优先在排针上找丝印**（`PA13`/`SWDIO`）而不是去点芯片。
> 实在要量芯片：右上角那一片的 `74 = VSS` 与板子 GND 相通，可以拿它当参考点，往下两格就是 72 = PA13。

### 第一步：看丝印（优先，最省事）
长排针旁边一般印着 `PA6` / `PC6` / `5V` / `3V3` / `GND`。能看清就直接用，并在板边贴上标记。
**如果丝印看不清或者看不全：把两个长排针拍清楚发我**（要能看清每个孔旁边的字），我给你排成"第几孔 = 哪个脚"的对照表，再更新到这本手册里。

### 第二步：万用表通断档（断电测）
思路是"把一根表笔固定在已知网络上，另一根去点孔"：
- **找 GND**：黑笔固定在 Micro USB 金属壳（或电池负极），红笔点孔，蜂鸣 = 这个孔是 GND；
- **找 5V / 3V3**：先只插 Micro USB 上电，用直流电压档量孔对 GND 的电压（5 V / 3.3 V），记下来后再断电；
- **找 PA6 这类信号脚**：需要把表笔点在 MCU 引脚上。LQFP100 是 0.5 mm 间距，用尖表笔可以点到（**PA6 = 第 31 脚**，PA7 = 32，PB6 = 92，PB7 = 93，PB10 = 47，PB11 = 48，PC6 = 63，PC7 = 64，PC9 = 66，PD0 = 81，PD1 = 82，PD2 = 83，PD3 = 84，PD12 = 59，PD13 = 60，PA2 = 25，PA3 = 26，PA9 = 68，PA10 = 69，PA13 = 72，PA14 = 76）。
- 这比看图纸可靠得多，因为它是"实测"。

### 第三步：引脚扫描固件（最省事，推荐）
把下面这段代码**临时**放进 `main.c`：

1. 把函数体贴在 `/* USER CODE BEGIN 4 */` 和 `/* USER CODE END 4 */` 之间（文件末尾那个区域）；
2. 在 `main()` 的 `/* USER CODE BEGIN 2 */` 里、**所有 `XXX_Init()` 之前**调用一次 `PinScan_Run();`。

烧录后：单片机每 3 秒把**一个**待用引脚拉高，同时从 USART2 发出它的名字（`$PIN,PA6`）。
你用万用表**直流电压档**（黑笔 GND、红笔点排针孔）找那个 3.3 V 的孔；或在孔和 GND 之间串一个 **LED + 1 kΩ 电阻**看它亮 —— 亮/有 3.3 V 的那个孔，就是当前报出的引脚。18 个引脚报完会循环，可以慢慢找。

> 看输出：串口助手直接看，或用 `python tools\telemetry_monitor.py --port COM5 --show-bad`（非 `$CAR` 行会以 `[其他]` 原样显示）。

```c
/* ==== 临时引脚定位工具：找完引脚请删掉 ==== */
static void PinScan_Run(void)
{
  static const struct { const char *name; GPIO_TypeDef *port; uint16_t pin; } list[] =
  {
    {"PA6",  GPIOA, GPIO_PIN_6},  {"PA7",  GPIOA, GPIO_PIN_7},
    {"PA8",  GPIOA, GPIO_PIN_8},  {"PA9",  GPIOA, GPIO_PIN_9},
    {"PA10", GPIOA, GPIO_PIN_10},
    {"PB6",  GPIOB, GPIO_PIN_6},  {"PB7",  GPIOB, GPIO_PIN_7},
    {"PB10", GPIOB, GPIO_PIN_10}, {"PB11", GPIOB, GPIO_PIN_11},
    {"PC6",  GPIOC, GPIO_PIN_6},  {"PC7",  GPIOC, GPIO_PIN_7},
    {"PC9",  GPIOC, GPIO_PIN_9},
    {"PD0",  GPIOD, GPIO_PIN_0},  {"PD1",  GPIOD, GPIO_PIN_1},
    {"PD2",  GPIOD, GPIO_PIN_2},  {"PD3",  GPIOD, GPIO_PIN_3},
    {"PD12", GPIOD, GPIO_PIN_12}, {"PD13", GPIOD, GPIO_PIN_13}
  };
  GPIO_InitTypeDef g = {0};
  uint8_t i;

  __HAL_RCC_GPIOA_CLK_ENABLE();
  __HAL_RCC_GPIOB_CLK_ENABLE();
  __HAL_RCC_GPIOC_CLK_ENABLE();
  __HAL_RCC_GPIOD_CLK_ENABLE();

  for (;;)
  {
    for (i = 0u; i < (uint8_t)(sizeof(list) / sizeof(list[0])); i++)
    {
      char        msg[16];
      uint8_t     n = 0u;
      const char *p = list[i].name;

      g.Pin   = list[i].pin;
      g.Mode  = GPIO_MODE_OUTPUT_PP;
      g.Pull  = GPIO_NOPULL;
      g.Speed = GPIO_SPEED_FREQ_LOW;
      HAL_GPIO_Init(list[i].port, &g);
      HAL_GPIO_WritePin(list[i].port, list[i].pin, GPIO_PIN_SET);

      msg[n++] = '$'; msg[n++] = 'P'; msg[n++] = 'I'; msg[n++] = 'N'; msg[n++] = ',';
      while ((*p != '\0') && (n < 12u)) { msg[n++] = *p; p++; }
      msg[n++] = '\r'; msg[n++] = '\n';
      (void)HAL_UART_Transmit(&huart2, (uint8_t *)msg, n, 50u);

      HAL_Delay(3000u);

      HAL_GPIO_WritePin(list[i].port, list[i].pin, GPIO_PIN_RESET);
      g.Mode = GPIO_MODE_INPUT;          /* 松开，避免两个脚互顶 */
      HAL_GPIO_Init(list[i].port, &g);
    }
  }
}
```

```c
  /* USER CODE BEGIN 2 */
  PinScan_Run();     /* 临时：引脚定位用，测完删掉这一行 */

  HAL_Delay(TRACK_POWER_ON_DELAY_MS);
  Telemetry_Init();
  ...
```

⚠️ 三个注意点：
1. 必须在**外设初始化之前**调用（它会把这些引脚配成普通 GPIO，放在后面会把编码器/PWM/串口的复用功能顶掉）；
2. 扫描期间先把 **TB6612 的 VM 电池断开**、或让轮子离地，避免引脚被逐个拉高时电机抽动；
3. **测完务必删掉这一行并重新烧回正常固件**，否则整个程序停在这个循环里，什么都不会跑。

---

## 13. 编译环境：怎么打开工程、改代码、编译、烧录

好消息：**这台电脑上的编译环境我已经搭好了**（ARM GCC 14.2.1 + pyocd 烧录工具），你只要敲命令就行。
（以前那个 `XunjiCar.elf` 是在另一台电脑上（用户名 `13227`）编的，本机原本没有编译器。）

### 13.1 要改的文件在哪

工程根目录：`xunjicar\XunjiCar\XunjiCar\`

| 文件 | 内容 | 改的频率 |
|---|---|---|
| `Core\Inc\line_follow.h` | **循迹速度、PID、丢线、避障距离** | ★★★ 调车主要改这个 |
| `Core\Src\line_follow.c` | 循迹控制环本体（逻辑，一般不用动） | ★ |
| `Core\Inc\track_uart.h` | 循迹模块的极性与超时 | ★★ |
| `Core\Inc\motor_test.h` | 电机测试序列开关、编码器线数/减速比 | ★ |
| `Core\Inc\telemetry.h` | 遥测帧里包含哪几类数据 | ★ |
| `Core\Inc\vl53l0x.h` | 激光测距的时间预算等 | ★ |
| `Core\Src\*.c` | 其余源码 | 少 |
| `Drivers\` | ST 官方 HAL 库，**不要动** | — |

**打开方式**（任选一种）：
- **VSCode（推荐）**：文件 → 打开文件夹 → 选 `xunjicar\XunjiCar\XunjiCar`；有语法高亮，改错了会标红。
- 直接双击某个 `.h` 用记事本改也行，但容易改坏，改完记得保存（Ctrl+S）。

### 13.2 编译（一条命令）

在 `xunjicar` 目录下执行：

```powershell
powershell -ExecutionPolicy Bypass -File tools\build.ps1
```

- 大约 30 秒，最后出现 `==== 编译成功 ====` 和 Flash/RAM 占用（现在约 31 KB / 512 KB）。
- 产物在 `XunjiCar\XunjiCar\build\out\`：`XunjiCar.elf`、`XunjiCar.hex`、`XunjiCar.bin`。
- 改代码后**必须重新编译**才有效果；只编译不烧录，板子上跑的还是旧程序。
- 编译报错时会标出文件名和行号，照着改即可（一般是你改参数时多打/少打了括号）。

### 13.3 烧录（ST-Link V2，一条命令）

#### 13.3.1 接线（只需要 4 根线）

> ⚠️ **先别搞混：PA13/PA14 是 SWD 调试口，不是串口！**
> 板上写着 `RX2`/`TX2` 的是 **PA2/PA3**（给 USB-TTL 看数据用），`TX1`/`RX1` 是 **PA9/PA10**（接循迹模块）。
> ST-Link 只接 **PA13(SWDIO)** 和 **PA14(SWCLK)** 这两个。接错了不会烧东西，只是连不上芯片。

| ST-Link V2 | 开发板 | 板上丝印可能写成 | 说明 |
|---|---|---|---|
| **SWDIO** | **PA13** | `PA13`、`SWDIO`、`JTMS`、`DIO` | 数据线 |
| **SWCLK** | **PA14** | `PA14`、`SWCLK`、`JTCK`、`CLK` | 时钟线 |
| **GND** | **GND** | `GND` | 必须接（共地） |
| **3.3V** | **3V3** | `3V3` | 接上更稳（电平参考）；**不要接 5V** |
| RST | 可不接 | `RST` | 烧录用不到 |
| SWO | 不接 | `SWO` | 调试追踪用 |

**优先找板上那组 4~5 针的专用调试排针**（一般单独一小撮，丝印是 `3V3 SWDIO SWCLK GND`，有的带 `RST`）；
找不到就到两排长排针上找 `PA13` / `PA14` 两个孔。

#### 你这块板上的调试排针（实测丝印：`BT0 3V3 GND DIO CLK`）

| 板上丝印 | 真实含义 | 接到 ST-Link |
|---|---|---|
| **DIO** | **SWDIO = PA13** | **SWDIO**（克隆版也常印 `DIO`） |
| **CLK** | **SWCLK = PA14** | **SWCLK**（克隆版也常印 `CLK`） |
| **GND** | 地 | **GND** |
| **3V3** | 3.3V 电平参考 | **3.3V** |
| **BT0** | **BOOT0**（启动模式选择） | **什么都不要接！** |

> ⚠️ **BT0 = BOOT0，不是调试信号**：
> - BOOT0 = 低（默认，内部有下拉电阻）→ 从 Flash 启动，跑你的程序 ← 正常
> - BOOT0 = 高（短接到 3V3）→ 进入出厂 Bootloader，**烧进去的程序不会运行**，板子看起来"像死的"
>
> 这就是为什么插线要**一根一根插并核对丝印**：这个 5P 排针的顺序和你 ST-Link 上的顺序不一定一样，
> 用 5P 整体排线直接怼，很容易把 3.3V 送进 CLK、或者把某根线送到 BT0 上。
> （顺带一提：想用"串口 ISP"下载程序时，才需要故意把 BT0 短到 3V3。）

> ⚠️ **按你 ST-Link 外壳上的丝印接线，不要按线的颜色接。**
> 蓝色铝合金那款克隆版是 2×5 的 10 针排针，外壳上激光刻着每个脚的名字（`3.3V` / `SWDIO` / `SWCLK` / `GND` / `SWO` / `RST`…），
> 你只需要找到 `3.3V`、`SWDIO`、`SWCLK`、`GND` 这 4 个，其余不用管。不同批次排列不一样，所以别背位置。
> 如果你的 ST-Link 是 **20 针标准排针**：1=VTref(3.3V)、2=SWDIO、4=SWCLK，3/5/9/13/15/17/19 都是 GND（随便接一个）。
>
> 接反 SWDIO/SWCLK **不会烧坏东西**，只是连不上；真正要小心的是别把 5V 接进 3V3。

供电：**板子自己用 Micro USB 或 5V 供电**。ST-Link 的 3.3V 只能出几十 mA，带不动整块板（尤其接了电机之后）。

#### 13.3.2 烧录步骤

1. ST-Link 插到电脑 USB 口（先看设备管理器里有没有认到 `STLink`；没认到要先装驱动，见 13.3.3）。
2. 按上表接好 4 根线，板子上电。
3. 在 `xunjicar` 目录执行：

```powershell
powershell -ExecutionPolicy Bypass -File tools\flash.ps1
```

成功时会看到 OpenOCD 打印 `** Verified OK **`，脚本最后输出：

```
烧录成功，芯片已复位运行。
```

4. 烧完芯片自动复位并开始跑：**先把车放到黑线上再上电/复位**，因为 1 秒后它会自己起步。

#### 13.3.3 常用参数与故障排查

```powershell
# 只测试连接（不烧录），用来判断是接线问题还是固件问题
powershell -ExecutionPolicy Bypass -File tools\flash.ps1 -Check

# 克隆版 ST-Link 不稳定 / 杜邦线较长时，把 SWD 降速到 500 kHz
powershell -ExecutionPolicy Bypass -File tools\flash.ps1 -Speed 500

# 芯片被读保护、或换过芯片：全片擦除后重烧
powershell -ExecutionPolicy Bypass -File tools\flash.ps1 -Erase
```

| 现象 | 原因 | 处理 |
|---|---|---|
| `Error: open failed` | 电脑没认到 ST-Link | 换 USB 口/线；装 ST-Link 驱动；确认设备管理器有 `STLink` |
| `Error: init mode failed` | 芯片没供电，或 SWD 线接错/太长 | 给板子供电；查 SWDIO→PA13、SWCLK→PA14；降速 `-Speed 500` |
| 提示 target not halted / 校验失败 | 调试口被别的软件占用 | 关掉 Keil / STM32CubeIDE / CubeProgrammer / 残留的 openocd 进程 |
| 能连上但写入报错 | 芯片读保护 | 加 `-Erase` |
| 烧完没反应 | 没重新上电 | 拔插一次电源（或按复位键） |

> 说明：这台电脑上没有装 STM32CubeProgrammer，用的烧录工具是 **OpenOCD 0.12**（PlatformIO 包，原生支持 STM32F407，不需要额外芯片支持包）。
> 你也可以用已装的 **Keil** 烧，但要先建工程，不如这条命令快。

### 13.4 看数据（一条命令）

```powershell
python tools\telemetry_monitor.py --list                    # 先找串口号
python tools\telemetry_monitor.py --port COM5 --csv run1.csv # 边看边存 CSV
```

正常一行长这样（新增了 `控制/偏差/差速` 三个字段）：

```
[20:15:03] N=421  循迹[···█····] 1路压线  测距 左235mm 右412mm  AZ=16384 T=25C
           控制=RUN 偏差=-125 差速=+6%  电机 MANUAL MA=+30% EA=+312 MB=+36% EB=+298
```

---

## 14. 循迹参数调试实战（先看这一节再动车）

### 14.1 第一步：把车架空，先确认"看得见线"

轮子离地（车架空），上电，把车**用手在黑白线上左右移动**，同时看上位机：

| 你看到的 | 说明 | 怎么办 |
|---|---|---|
| `循迹[···█····]` 随位置变化 | 传感器正常 | 继续 |
| 压黑线处显示 `█`、白底显示 `·` | 极性正确 | 继续 |
| 压黑线显示 `·`、白底显示 `█` | 极性反了 | `line_follow.h` 的 `LF_BLACK_IS_ZERO` 改 0（或 `track_uart.h` 的 `TRACK_DATA_WHITE_IS_ONE` 改 0） |
| 一直 `TRK=ERR` | 模块没数据 | 回到 §5 故障表查循迹模块 |
| 车往左偏时 `偏差` 变**正** | 左右方向反了 | 把两个电机的线对调，或把 `x1~x8` 的权重反过来（告诉我，我改代码） |

**判据**：车往左移，`偏差` 变负；车往右移，`偏差` 变正；正中间 `偏差≈0`。

### 14.2 第二步：架空看控制输出

保持轮子架空，用手模拟线偏移，观察 `差速`：

- 车放正中 → `差速≈0%`，两个轮子同速转；
- 车偏右 → `差速` 变成正数，`MA`（左轮）变大、`MB`（右轮）变小 —— 车头会向右修正；
- `控制=RUN` 表示控制环在正常工作。

**判据**：`差速` 随偏移连续变化，符号方向正确，绝对值不超过 `LF_STEER_LIMIT`。

### 14.3 第三步：落地调参（按这个顺序，一次只改一个数）

| 顺序 | 改什么 | 目标 | 现象 → 调整 |
|---|---|---|---|
| 1 | `LF_BASE_DUTY`（先 25~30） | 车能沿直线慢慢走 | 走不动/卡顿 → 加大；太快冲出去 → 减小 |
| 2 | `LF_KP`（先 30，每次 +10） | 能跟住缓弯 | 过弯冲出去（欠调）→ 加大；直道来回猛摆（过调）→ 减小 |
| 3 | `LF_KD`（先 10，每次 ±5） | 摆动被压住 | 摆得厉害 → 加大；车发抖/一顿一顿 → 减小 |
| 4 | `LF_STEER_LIMIT` | 急弯不甩出去 | 急弯翻车/冲出 → 减小 |
| 5 | `LF_LOST_TIMEOUT_MS` | 断线/虚线不误停 | 过虚线就停 → 加大到 500~800 |
| 6 | `LF_LOST_ACTION` | 丢线行为 | 调参阶段保持 0（停下最安全）；比赛改 1 |
| 7 | `LF_STOP_DISTANCE_MM` | 障碍停车 | 不想避障 → 填 0 |

**记住这个经验值**：`KP` 决定"敢不敢拐"，`KD` 决定"拐得稳不稳"，`BASE_DUTY` 决定"跑多快"。
**一次只改一个参数**，改完编译 → 烧录 → 试车，否则你分不清是哪个参数起的作用。

### 14.4 用 CSV 看"到底哪里不对"

```powershell
python tools\telemetry_monitor.py --port COM5 --csv run1.csv
```

把车跑一段，然后用 Excel 打开 `run1.csv`，看这几列：

| 列 | 怎么看 |
|---|---|
| `bits` | 每秒 10 次的 8 路状态，能还原整条线的轨迹 |
| `err` | 偏差曲线。**规则的小波浪 = 正常；越来越大的振荡 = KP 太大；一直偏一侧 = 传感器没校准或左右轮速不一致** |
| `steer` | 修正量，和 err 同向变化 |
| `ea` / `eb` | 两个轮子的实际转速。**同样的占空比下两者差很多 = 电机特性不一致/接线问题** |
| `d1_mm` / `d2_mm` | 前方距离，用来标定避障阈值 |

### 14.5 常见症状速查

| 症状 | 最可能的原因 | 改哪个 |
|---|---|---|
| 原地打转 / 往一边跑 | 电机线接反、或左右轮装反 | 硬件，或对调 `Motor_SetDuty` 的两个参数 |
| 压着线但完全不动 | `LF_AUTO_START=0` 或还没过启动延时 | 等 1 秒；或检查循迹数据是否有效 |
| 一味直行不修正 | `LF_KP` 太小，或偏差恒为 0（探头全白/全黑） | 加大 KP；检查 `B=` 是否随位置变化 |
| 直道画龙（来回摆） | KP 过大 / KD 过小 / 速度过快 | 减 KP、加 KD、降 BASE_DUTY |
| 过弯直接冲出去 | KP 过小 / 速度过快 / 差速上限太小 | 加 KP、降速度、加 STEER_LIMIT |
| 缓弯、60~70° 弯都行，**快 90° 的急弯**勉强 | 差速上限被顶到饱和（急弯专用） | 只加 `LF_STEER_LIMIT`（见 14.6），**别动 KP** |
| 抖动一下就停 | 丢线判太快 | 加 `LF_LOST_TIMEOUT_MS` |
| 一上电就冲出去 | 没放好车；`LF_START_DELAY_MS` 太短 | 加延时；先把车摆正再上电 |

### 14.6 本次调参记录：快 90° 急弯勉强（直道与 60~70° 弯已达标）

**症状**：直道很稳、60~70° 的弯没问题，只有快 90° 的急弯"勉强，差点跑出线"。

**判断**：能过的弯都没问题 → `LF_KP`/`LF_KD`/`LF_KGYRO` 都不要动
（动了就会把已经调好的直道和 60~70° 弯一起改坏）。急弯是**唯一会把差速顶到饱和**的工况，
所以问题在"急弯时能拿到的差速不够"，也就是 `LF_STEER_LIMIT` 这一项。

**为什么上限 50 会让急弯不够**：`差速` 指令 = KP·偏差 + KD·(偏差变化) + KGYRO·角速度，无论多大最后都被
`LF_STEER_LIMIT` **封顶**。上限 50 时两轮占空比只能是 `[40-50, 40+50] = [-10, +90]`：
内轮**最多只到 -10%**（还在往前转，等于没怎么刹车）。更关键的是急弯时车转得很快，
陀螺仪阻尼项（16.3 那个 `LF_KGYRO=18`）会**吃掉一大块修正量**，真正用于拐弯的就更少了。

**第二轮：50 → 60 之后仍然勉强**，说明光提高上限不够，于是把真正卡住急弯的那个机制也改掉：

| 参数/代码 | 改前 | 改后 | 为什么 |
|---|---|---|---|
| `LF_STEER_LIMIT` | 60 | **70** | 这一项还决定"**内轮能倒转多少**"：两轮 = 基础速度 ± 差速。上限 50 → 内轮最好 −10%（还在往前转）；70 → 内轮 **−30%（真的在倒转）**。内轮倒转才拉得出最小转弯半径 |
| `line_follow.c` 6.5 节 | 陀螺仪恒为 100% | **偏差小 → 100%，偏差 >350 → 线性降到 55%** | 陀螺仪的职责是"不许车随便转"，急弯要求的恰恰是"必须转过去"，两者天生对立。而且它加在限幅**之前**：急弯时 300 dps × KGYRO = 54% 差速，把总指令顶进饱和区。拿上限 70 算：不衰减只剩 `70-54 = 16`（急弯过不去），衰减到 55% 有 `70-29.7 = 40`（够用） |
| `LF_BASE_DUTY` | 40 | 40（不变） | 你要求速度不变（**降速是治急弯最有效的一招**，但不能用） |
| `LF_KP` / `LF_KD` / `LF_KGYRO` | 45 / 12 / 18 | 不变 | 这三项影响所有工况，能过的弯已经合格，不动 |

> 后来又按你的要求把配速提到 **45**，`LF_KD` / `LF_KGYRO` 随之同比加大 —— 那是最后一次调参，
> 完整记录在 **14.7**（含"为什么改速度必须跟着改阻尼"）。

**⚠️ 第三轮（重要教训）：衰减范围一开始定错了，直道又开始摆动**

第一版的衰减是从**偏差 0** 就开始的连续斜坡，结果：

| 偏差 | 第一版阻尼 | 偏差 | 第一版阻尼 |
|---|---|---|---|
| 35 | 90% | 175 | 70% |
| 70 | 80% | 350 | 40% |

直道摆动刚起来时偏差大约就在 **100~200**，阻尼已经被削到 **70~80%** —— 正好把 16.5 里好不容易
调出来的小幅防摆又放掉了，所以"过弯都 OK 但直线又摆"。**这是把两种工况的判据混淆了。**

**现在改成"先留一条不衰减的带子"**：8 路探头的归一化偏差是 ±1000，"一个探头的间距"约 100，
所以偏差 **350** 意味着线已经跑到第 4 个探头以外 —— 正常走线（含直道摆动和 60~70° 弯）根本到不了，
只有真急弯才会超过：

| 偏差 | 阻尼比例 | 说明 |
|---|---|---|
| 0 ~ 350 | **100%** | 直道 + 缓弯 + 60~70° 弯，和调好时**完全一样** |
| 500 | 90% | 开始让路 |
| 675 | 78% | |
| 1000（急弯深处） | **55%** | 只砍掉 45%，够拐又不失控 |

> 要改这个 350 就改 `line_follow.c` 6.5 节里的 `taper_lo`（`taper_hi`=1000、最低 55% 一起看）。
> **别再把起点往前移** —— 起点越靠近 0，直道越容易重新摆起来，这就是第三轮的教训。

**试车看什么**：

| 现象 | 下一步 |
|---|---|
| 90° 弯能过了 | 如果还有点勉强 → **14.8 的急弯自动降速**（不是加 `LF_STEER_LIMIT`，原因见 14.8） |
| 直道开始"一顿一顿"或轻微发抖 | 上限太大把噪声放出来了：退回 65 |
| 出弯时**往另一边甩**（过冲） | 衰减给多了：把 `line_follow.c` 里的最低比例 55 往上调（60~65） |
| 直道又摆起来 | 衰减带太窄：把 `taper_lo` 从 350 往上加（400~450），**不要动 `KGYRO`** |
| 90° 弯仍然转不过来 | 见下面，**基本是物理限制或丢线判断**，别再堆参数 |

**⚠️ 如果 70 + 衰减还不行，请告诉我一个现象（这决定下一步方向）**：
试急弯时看上位机那行的 **`控制=`** 和 **`差速=`**：

| 急弯瞬间看到 | 说明 | 下一步 |
|---|---|---|
| `控制=RUN`，`差速` 贴着 ±70 | 差速已经饱和，是**卡在物理极限**：要么降速，要么把探头往前挪 | 见下面 1、2 |
| `控制=COAST` 或 `LOST` | 急弯**把线甩出探头视野了** —— 这时车是在"盲跑"，再大的差速也没用 | 我把 `LF_LOST_TIMEOUT_MS`（350ms）加大到 500~600，让它盲跑的时间够过弯 |
| `控制=RUN`，但 `差速` 离 70 还远 | 说明 KGYRO 或 KD 在压制转向（不是限幅问题） | 我把衰减再放宽，或单独降 KGYRO |

**如果确认是物理限制，别再堆参数**：

1. **降速**最有效（`LF_BASE_DUTY` 40 → 34），但你要求速度不变，所以先不用；
2. **探头位置**：8 路探头如果装在**后轴附近或偏后**，直角弯时前轮会"切内角"，探头来不及看到线 ——
   把探头往前挪（靠近前轴）比改参数有用得多；
3. 想让急弯**自动降速**、"平时不减速" —— ✅ **已经实现**，见 **14.8**（`LF_CORNER_SPEED_DROP`），
   直线速度完全不受影响。

### 14.7 本次调参记录：整体提速到 45（直道/60/70/90° 全部达标之后）

**前提**：14.6 那一轮结束后直道、60°、70°、90° 弯全部 OK，手感"完美"。这时要求把配速提到 45。

**改了三个参数**（不是只改速度）：

| 参数 | 改前 | 改后 | 为什么 |
|---|---|---|---|
| `LF_BASE_DUTY` | 40 | **45** | 你要的配速（+12.5%） |
| `LF_KD` | 12 | **14** | KD 压的是"**每周期位置变了多少**"。速度一快，同样的偏差在 10 ms 里变化得更多，等效阻尼会变弱，所以同比加大 |
| `LF_KGYRO` | 18 | **20** | 同理（陀螺仪项本身与速度无关，但整车的等效阻尼比要跟上），另外它还是 16.5 里压小幅摆动的主力 |
| `LF_KP` | 45 | 45（不变） | **KP 只放大偏差大小，和快慢无关**。而且速度提高后，同样的偏差在一秒内偏得更多，PD 算出来的修正率自动变大 —— 本来就够，再加大反而摆 |
| `LF_STEER_LIMIT` | 70 | 70（不变） | 两轮 = 速度 ± 上限，上限占速度的比例只是从 1.75 掉到 1.56，仍然够把内轮拉成倒转（45−70 = **−25%**）。提到 80 只是把余量还给上限；**一旦急弯变勉强，先这样做，而不是先减 KD** |
| `line_follow.c` 衰减带 | 350 / 55% | 不变 | 判据是**几何量**（350 ≈ 第 4 个探头之外），与速度无关，因此整条带子的含义不变 |

**提速的代价（这次试车要重点看这三条）**：

| 观察项 | 为什么 | 现象 → 怎么办 |
|---|---|---|
| 急弯 90° | 同样半径，速度越快要求转得越快。**而且外轮会先顶到 100%**（45+70=115），差速被限幅 | 又变勉强 → 见 **14.8**（急弯自动降速），**不要只加上限** |
| 丢线 / 虚线 | `LF_LOST_TIMEOUT_MS`（350 ms）是**时间**，速度一快它对应的**距离**也变长（45 时约 17~18 cm） | 过虚线被误判成丢线 → 加大到 450~500；反过来如果冲得太远 → 减到 300 |
| 避障刹车距离 | 速度越快，同样反应时间滑行越远（激光默认是关的，这条等开激光时再看） | 开激光时把 `LF_STOP_DISTANCE_MM` 从 150 往上加 |

**试车判断顺序**（一次只改一个数）：

1. 直道有没有重新出现小幅摆动？有 → `LF_KGYRO` 20 → 24（别先动 KP）；
2. 90° 弯过不过得去？勉强 → 走 14.8 的急弯降速，**不要只加 `LF_STEER_LIMIT`**；
3. **都正常就不要再动了**。

> 想再往上提速（比如 50）：照这张表再同比走一遍即可 ——
> **速度每提高 10%，`LF_KD` 和 `LF_KGYRO` 也跟着提高约 10%，`LF_KP` 不动。**
> 但越往上余量越小：速度越高，急弯越难、对 `LF_STEER_LIMIT` 的依赖越大，到某个点就必须
> 靠"急弯自动降速"（14.8）才能两全。

### 14.8 本次调参记录：配速 45 之后的 90° 急弯（急弯自动降速）

**症状**：配速提到 45 后，**直线无摆动、60°/70° 弯都没问题，只有 90° 急弯有点勉强**。

**关键判断：这次缺的不是"差速上限"，是"外轮没有余量"**

两轮的占空比是 `基础速度 ± 差速`。基础 45、上限 70 时想给 `45+70 = 115%`，但占空比最大只有 100%，
所以**外轮被限幅在 100%**，实际差速只有 `100-45 = 55`，而不是 70。这就解释了为什么"只加 `LF_STEER_LIMIT`"没用：

| 方案 | 上限 | 外轮 | 内轮 | 实际差速 |
|---|---|---|---|---|
| 改前 | 70 | 100（顶死） | −25 | 55 |
| 只加上限 | **80** | 100（还是顶死） | −35 | 65 |
| **急弯降速（本次采用）** | 70 | 100 | **−29** | **129** ⬅ |

**改了什么**（只改"急弯那一下的速度"，直线速度不变）：

| 参数 / 代码 | 改前 | 改后 | 为什么 |
|---|---|---|---|
| `line_follow.c` 第 7 节 | 基础速度恒定 = `LF_BASE_DUTY` | 偏差 >400 时**按比例下压基础速度**，最多降到 `45-12 = 33` | 把基础速度压下来之后，内轮能倒转到 −29%、外轮仍给满 100%，实际差速从 55 变成 **129**。**降速还能直接减小所需转弯半径**，所以这是双管齐下 |
| `LF_CORNER_SLOW_POS` | — | 新增 `400` | 哪里开始降速。8 路探头归一化偏差 ±1000、一个探头间距约 100，所以 400 = 第 4 个探头之外，直线和缓弯都到不了 |
| `LF_CORNER_SPEED_DROP` | — | 新增 `12` | 最多降 12% 占空比（45 → 33）。嫌少就 15，嫌多就 8，**不想要这个功能就填 0** |
| `LF_BASE_DUTY` / `LF_KP` / `LF_KD` / `LF_KGYRO` / `LF_STEER_LIMIT` | 45/45/14/20/70 | **全部不变** | 直线和 60/70° 弯已经完美，一个都不动 |

**验证过的事实**（把这段算法单独复刻出来跑了一遍）：

- 直线（偏差 50 / 150 / 300）→ 基础速度**始终是 45**，一点没降；
- 偏差 400 才开始降：650 → 39，900 → 33（降满）；
- 90° 急弯：偏差 700 时基础 38，差速 +67~70，两轮 100 / −29；
- 全范围扫描 1683 个工况点，两轮占空比都在 ±100 之内，没有越界。

**试车看什么**：

| 现象 | 下一步 |
|---|---|
| 90° 能过了 | 还想更稳 → `LF_CORNER_SPEED_DROP` 12 → 15 |
| **出弯后加速时有点顿/窜** | 降速太狠或太突然 → `LF_CORNER_SPEED_DROP` 改 8~10 |
| 直道速度被拖慢了 | 不该发生（直线偏差到不了 400）；若真发生，把 `LF_CORNER_SLOW_POS` 加到 500 |
| 90° 仍然勉强 | 把 `LF_CORNER_SPEED_DROP` 加到 15~18；还不行就是探头位置/机械限制，见 14.6 结尾 |

> 这张表也说明了前面几轮的取舍：**"速度不变"和"急弯过得去"之间，唯一的两全办法就是
> "只在急弯降速"** —— 现在这条逻辑已经实现了，直线速度完全按你要求的 45 保持不变。

---

## 15. 激光测距（避障）怎么调

> ### ⚠️ 先看这里：激光测距的总开关默认是**关**的
>
> `line_follow.h` 里的 **`LF_ENABLE_TOF_LASER`** 现在默认 `(0)`，也就是说：
>
> | 关着（默认） | 开着（改成 `1` 重新编译烧录） |
> |---|---|
> | 上电**不初始化** VL53L0X，两个模块连探测都不做 | 逐路探测 + 初始化 + 连续测量 |
> | 上位机帧里**没有** `D1=` / `D2=` 两个字段 | 有 `D1=` / `D2=`，后面 15.1~15.4 才谈得上 |
> | `LF_STOP_DISTANCE_MM` / `LF_RESUME_DISTANCE_MM` / `LF_USE_FRONT_TOF` **全部不生效** | 三个参数按 15.3 生效 |
> | 不存在"前方有障碍"误刹车，控制环只认循迹 | 距离小于 `LF_STOP_DISTANCE_MM` 就停车（迟滞恢复） |
>
> 整段避障代码是**条件编译**掉的（不是运行时判断），所以关着的时候连那两个 TOF 的
> 显存、I2C 读写、避障逻辑都不占，帧也短一截。
> 要重新用激光避障：把 `LF_ENABLE_TOF_LASER` 改成 `(1)` → `1-编译固件.cmd` → `3-烧录固件.cmd`。
> 改完顺手确认 `telemetry.h` 的 `TELEMETRY_ENABLE_TOF` 还是 `(1u)`（开着开关却把它改成 0 会直接编译报错提醒你）。
>
> 下面 15.1 开始的内容，前提都是 **`LF_ENABLE_TOF_LASER = 1`**。

### 15.1 哪一路是左、哪一路是右（已实测确认）

要分清**两件不同的事**，它们不是一回事：

| | 由什么决定 | 记载位置 |
|---|---|---|
| **路号 `D1` / `D2`** = 挂在哪条总线 | **硬件接线**，接线不改就不会变 | `README.md` 引脚表、`telemetry.c` 的 `s_tof_bus[]` |
| **哪一路在车的左边** | **模块装在哪边**（已实测确认，写在代码里） | `line_follow.h` 的 `LF_TOF_LEFT` / `LF_TOF_RIGHT` |

**实测结论（装车后已确认，直接用，不用再猜）：**

| 路号 | 帧里字段 | 总线 | 引脚 | 对应模块 | **装车位置** |
|---|---|---|---|---|---|
| 0 | `D1` | I2C1 | PB6=SCL / PB7=SDA | TOF 1 号 | **左边** |
| 1 | `D2` | I2C3 | PA8=SCL / PC9=SDA | TOF 2 号 | **右边** |

代码里就是这两行（`line_follow.h`，整个工程唯一的左右定义处）：

```c
#define LF_TOF_LEFT              (0)   /* 左侧模块 → D1 / I2C1 */
#define LF_TOF_RIGHT             (1)   /* 右侧模块 → D2 / I2C3 */
```

所以上位机的 `测距 左235mm 右412mm` 里，**左 = `D1`、右 = `D2`**，可以放心照着调。

<details>
<summary>想再自查一遍（或以后模块换了位置）时怎么做</summary>

1. 上电，让上位机在刷 `测距 左=.. 右=..`；
2. 拿一张纸板**只挡左边**那个激光模块（约 20 cm 处）；
3. 看哪个数字掉下来：掉 `D1` → 左 = `D1`（当前结论）；掉 `D2` → 说明模块被换过位置；
4. 若与上表不符，把 `line_follow.h` 两行对调（`LF_TOF_LEFT` 改 `1`、`LF_TOF_RIGHT` 改 `0`），
   同时把 `tools/telemetry_monitor.py` 的 `("D1", "左")` 改成 `("D1", "右")`，重新编译。

只改"左/右"这个叫法，**不用动接线，也不用动 `D1`/`D2` 字段名**。

</details>

> 避障目前是"取两路里最近的那个"（`LF_USE_FRONT_TOF = 2`），所以左右叫错也不影响避障行为，
> 只影响你读数据和以后写"左侧障碍往右让"这类分侧逻辑。分侧阈值/分侧动作还没做，需要时再加。

### 15.2 校准读数

| 步骤 | 做法 | 判据 |
|---|---|---|
| 1 | 用尺子放在模块正前方 100 / 300 / 500 mm | `D1` 读数与尺子相差 ±30 mm 内 |
| 2 | 手快速挡住再移开 | 数字应立刻变化，无卡死 |
| 3 | 对着远处（>2 m） | 显示 `---`（无有效回波）属正常 |

超过 `TELEMETRY_DIST_MAX_MM`(2000 mm) 的读数会被判为无效并显示 `---`，要改就改 `telemetry.h`。

### 15.3 调避障行为

| 参数（`line_follow.h`） | 作用 | 建议 |
|---|---|---|
| `LF_STOP_DISTANCE_MM` | 小于它就停车 | 先设 200，量出实际刹车距离后再调到"能停住"的值 |
| `LF_RESUME_DISTANCE_MM` | 大于它才恢复 | 比停车距离大 50~100，防止在阈值附近抖动 |
| `LF_USE_FRONT_TOF` | 用哪一路 | 都朝前就用 `2`（取最近），只有一个朝前就填对应的 0/1 |

**刹车距离标定法**：让车正常跑，前方放个箱子，看 `D1/D2` 掉到多少时车停住、离箱子还有多远。
停车太晚（撞上）→ 加大 `LF_STOP_DISTANCE_MM`；停得太早 → 减小。

### 15.4 读数抖得厉害怎么办

当前代码是"拿到就用"，没滤波。如果发现距离数字跳动几十毫米导致误刹车，两个办法：
1. 加大 `vl53l0x.h` 的 `VL53L0X_MEASUREMENT_BUDGET_US`（33000 → 50000，更准更慢）；
2. 在 `line_follow.c` 里加 3 点中值滤波（告诉我，我给你加）。

---

## 16. 怎么用上 MPU6050 的数据（已实现）

`line_follow.c` 原来只用循迹 + 激光，MPU 只是被采样上报。现在**陀螺仪已经接进控制环**了，用的是它唯一真正有用的那个量：**Z 轴角速度（车转得多快）**。

### 16.1 加了什么

| 改动 | 说明 |
|---|---|
| **陀螺仪转向阻尼** | `steer += KGYRO × gz`：车正在往左转就自动给一点往右的修正，把"画龙"从源头压掉；**偏差大时会自动降到 40%**（急弯让路），见 14.6 |
| **丢线保持航向**（可选） | `LF_LOST_ACTION = 2`：丢线后用陀螺仪把航向锁住，沿原方向直行找线 |
| **上电自动零偏校准** | 100 次采样取平均（约 0.4 秒），扣掉陀螺仪固有的零点误差 |
| **采样提速** | 100 ms → **10 ms（100 Hz）**，控制环每周期都能拿到新数据 |
| **遥测新增字段** | `GZD=`（角速度，dps×10）、`YAW=`（丢线后累计转角，度×10）、`IMS=`（陀螺仪是否有效） |

**为什么阻尼比 KD 好用**：`LF_KD` 用的是"位置的变化率"，本质是**过去**的转动；陀螺仪测的是**当前**转动速度。所以同样是压摆动，陀螺仪这一项更及时、更不容易把系统带进振荡。

### 16.2 第一步：验证陀螺仪符号（不验就一定调歪）

接好 USB-TTL，上电后**把车拿在手里，原地向左转**（俯视逆时针），看上位机的 `角速度=` ：

| 你看到的 | 含义 | 怎么办 |
|---|---|---|
| `IMS=1`，左转时 `角速度` 是**正数** | 方向正确 | 不用改，默认 `LF_GYRO_SIGN=+1` |
| 左转时是**负数** | 芯片装反了（倒扣） | `line_follow.h` 里 `LF_GYRO_SIGN` 改成 `-1` |
| `IMS=0` | 陀螺仪没校准/没接上 | 查 I2C2（PB10/PB11）、AD0 是否接 GND |
| 车**静止**时 `角速度` 还有 ±5 dps 以上 | 校准时车在动 | 保持静止重新上电（校准只在上电时做一次） |

### 16.3 第二步：调 `LF_KGYRO`（阻尼力度）

当前值 `LF_KGYRO = 20`（10 → 18 是压"小角度走线轻微摆动"，18 → 20 是配合 40 → 45 提速，见 16.5 和 14.7），
意思是**每 1 dps 给 0.2% 差速**（转 200 dps ≈ 40% 差速）。

> **注意：这一项现在不是恒定的**。偏差在 **350 以内按 100% 出力**（上面这个换算成立，直道和缓弯都在这条带子里）；
> 偏差超过 350（只有真急弯才会）才线性降到 **55%**，目的是别让阻尼把急弯的转向修正吃掉 ——
> 原因和数字见 14.6。所以"直道防摆"和"急弯让路"是分开的两件事：调 `LF_KGYRO` 主要影响直道，
> 急弯那条衰减带（起点 `taper_lo`、最低 55%）在 `line_follow.c` 的 6.5 节里改。

调法（**先把 `LF_KD` 改成 0**，这样你能单独看到陀螺仪的效果）：

| 现象 | 调整 |
|---|---|
| 还是画龙 | 加大：18 → 22 → 26 |
| 车发抖、一顿一顿、反应发木 | 减小：14 → 12 → 10 |
| 刚好 | 再把 `LF_KD` 加回一点点（比如 4~6），和陀螺仪配合 |

经验：**陀螺仪阻尼能顶掉大部分 KD**。很多人最后是 `KP=45, KD=0~6, KGYRO=14~24` 这种配置。

> **前提**：这一项要生效，遥测帧里必须有 `IMS=1`。`IMS=0`（没接 MPU 或没校准成功）时
> 无论 `LF_KGYRO` 调多大都完全不参与计算，改了等于没改 —— 先看 `IMS`。

### 16.4 第三步（可选）：丢线时用航向保持找线

```c
#define LF_LOST_ACTION       (2)    /* 0=停车  1=原地转着找  2=保持航向直行找 */
#define LF_LOST_HOLD_MS      (800u) /* 最多直行找这么久 */
#define LF_KHOLD             (10)   /* 每偏 1 度给 1% 差速 */
```

行为：丢线 350 ms（`LF_LOST_TIMEOUT_MS`）后，把航向锁在那一刻，直行最多 800 ms；期间 `YAW=` 会显示已经偏了多少度，`差速` 会往反方向修。800 ms 还没找到线就停车。

适用：赛道有**断线、虚线、大十字、或者黑线被挡住**。如果你没有这类路段，保持 `LF_LOST_ACTION = 0` 最安全。

### 16.5 本次调参记录：小角度走线轻微摆动（速度未动）

**症状**：大幅度转弯没问题；小幅度（线约 10° 左右）走线时车有轻微左右摆动。

**判断**：大转弯正常 → `LF_KP` 够用、差速上限够用，**不用动 KP**；
小幅摆动是**阻尼不够**（小偏差时位置量化到单个探头，位置量 `err` 一跳，KP 就给出一次修正，车转过头再修回来）。

**改了什么**（只改一个参数，速度一项没动）：

| 参数 | 改前 | 改后 | 为什么 |
|---|---|---|---|
| `LF_KGYRO` | 10 | **18** | 陀螺仪阻尼看的是"车正在转多快"。线是直的时候它不出力，所以**不影响大转弯的修正能力**；只有车开始左右转才给反向差速 —— 正好压小幅摆动 |
| `LF_BASE_DUTY` | 40 | 40（不变） | 你要求速度不变 |
| `LF_KP` / `LF_KD` | 45 / 12 | 不变 | 一次只改一个数，先看陀螺仪这一项够不够（手册 14.3 的原则） |

**为什么不用加 `LF_KD`**：`LF_KD` 用的是"位置的变化率"，本质是**过去**的转动，而且它把探头的量化跳变也一起放大了；
陀螺仪是**当前**转动速度，更及时、更不容易把系统带进振荡（16.1 里已经写过这条）。

**试车时看什么**：

| 现象 | 结论 | 下一步 |
|---|---|---|
| 摆动明显变小 | 方向对 | 还想更稳就 18 → 22 → 26 |
| 车发木、跟弯变慢、直道开始"贴不住线" | 阻尼过头 | 退回 14 → 12 |
| 一点变化都没有 | 陀螺仪没生效 | 看遥测 `IMS=` 是不是 1；`IMS=0` 时 `LF_KGYRO` 改了等于没改 |
| 摆动还在但变成"一顿一顿" | 是 KD 在放大量化跳变 | 再把 `LF_KD` 从 12 往下调（先试 8），KP 仍然不动 |

> 如果按上面调到 `LF_KP` 也不得不降，那会牵动大转弯的表现 —— 到时候告诉我，我给你换成
> "小偏差单独降增益"的写法（而不是整体降 KP），这样大转弯的手感能保住。

### 16.6 注意事项

1. **上电时车必须静止约 0.5 秒**（自动零偏校准），否则阻尼方向会偏。校准只做一次，运行中不会重校（避免把运动当成零偏）。
2. 陀螺仪有**零漂**：`YAW=` 积分只在几秒内可信，不能拿它当长时间航向。
3. **加速度计（AX/AY/AZ）目前没参与控制**——它对循迹帮助不大。真要利用，只能是"检测车被抬起/翻车"这类保护逻辑（比如 `AZ` 远离 16384 就停车）。
4. 不想用就 `LF_USE_IMU` 改 0；**没接 MPU 时它会自动失效**（`IMS=0`，阻尼项按 0 处理），不用改代码也不会跑飞。
