pekeppp/xunjicar-speed45/XunjiCar/XunjiCar/Core/Src/main.c

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
/* Includes ------------------------------------------------------------------*/
#include "main.h"
#include "i2c.h"
#include "tim.h"
#include "usart.h"
#include "gpio.h"

/* USER CODE BEGIN Includes */
#include "track_uart.h"
#include "telemetry.h"
#include "motor_test.h"
#include "mpu6050.h"
#include "line_follow.h"
/* USER CODE END Includes */

/* USER CODE BEGIN PD */

/** ===== 调试开关: 让轮子一直慢慢转 =====
  * 1 = 上电 MOTOR_SPIN_DELAY_MS 之后, 两个轮子一直以 MOTOR_SPIN_DUTY 往前慢转.
  *     完全绕过 循迹 / 激光避障 / 丢线判断, 只用来单独验证
  *     "单片机 -> TIM8 PWM -> TB6612 -> 电机 -> 电池" 这一整条路是否正常.
  *     ★ 烧录前必须把轮子架空, 否则车会一直往前跑!
  * 0 = 正常循迹模式 (参数在 line_follow.h)
  * 想让它反转就把 MOTOR_SPIN_DUTY 写成负数. */
#define MOTOR_SPIN_TEST          (0)

/** 慢转占空比 (%): 20~25 是"慢慢转"; 太小(<15)克服不了静摩擦, 看起来像不转 */
#define MOTOR_SPIN_DUTY          (25)

/** 上电后等多久开始转 (ms): 留时间把车放稳、手拿开 */
#define MOTOR_SPIN_DELAY_MS      (3000u)

/* USER CODE END PD */


void SystemClock_Config(void);
/* USER CODE BEGIN 0 */

#if (MOTOR_SPIN_TEST == 1)
/** 轮子慢转调试模式: 起转时刻 */
static uint32_t s_spin_t0 = 0u;

/** 到点之后每个主循环刷新一次占空比, 把 PWM 一直保持住 */
static void MotorSpin_Task(void)
{
  if ((HAL_GetTick() - s_spin_t0) >= MOTOR_SPIN_DELAY_MS)
  {
    Motor_SetDuty(MOTOR_A, MOTOR_SPIN_DUTY);
    Motor_SetDuty(MOTOR_B, MOTOR_SPIN_DUTY);
  }
}
#endif

/* USER CODE END 0 */

/**
  * @brief  The application entry point.
  * @retval int
  */
int main(void)
{

  /* MCU Configuration--------------------------------------------------------*/

  /* Reset of all peripherals, Initializes the Flash interface and the Systick. */
  HAL_Init();

  /* Configure the system clock */
  SystemClock_Config();

  /* Initialize all configured peripherals */
  MX_GPIO_Init();
  MX_I2C2_Init();
  MX_USART2_UART_Init();
  MX_I2C1_Init();
  MX_I2C3_Init();
  MX_TIM3_Init();
  MX_TIM4_Init();
  MX_TIM8_Init();
  MX_USART1_UART_Init();
  /* USER CODE BEGIN 2 */
  /* Wait for the modules to stabilize after power-on
     (vendor line-tracking example uses 3000 ms) */
  HAL_Delay(TRACK_POWER_ON_DELAY_MS);

  /* Probe + init the VL53L0X and start continuous ranging.
     Safe when the sensor is absent: frames will show D=---mm
     注意: 激光测距总开关 LF_ENABLE_TOF_LASER (line_follow.h) 默认是 0(关),
           关着时这里不会去探测 VL53L0X, 帧里也没有 D1/D2 字段 */
  Telemetry_Init();

  /* Single-motor wiring test: TIM8_CH1 PWM + AIN1/AIN2 + TIM3 encoder.
     STBY is tied high in hardware, so it is not driven here.
     注意: MOTOR_TEST_AUTO_RUN 已改成 0, 上电不再自动跑测试序列,
           否则会和下面的循迹控制环抢电机. 要单测电机时再把它改回 1. */
  Motor_Init();

  /* MPU6050 on I2C2 (PB10/PB11): probe + configure; auto-retries if absent */
  MPU6050_Init();

#if (MOTOR_SPIN_TEST == 1)
  /* 调试模式: 不启动循迹控制环
     (它一看到"没线"或"有障碍"就会把电机停掉), 改成延时后让两个轮子一直慢转 */
  s_spin_t0 = HAL_GetTick();
#else
  /* 循迹控制环 + 激光避障: 参数全在 line_follow.h
     上电 LF_START_DELAY_MS 后自动开始 (LF_AUTO_START=1 时) */
  LineFollow_Init();
#endif

  /* To run the line-sensor calibration, uncomment these:
     enter calibrate -> sweep over the black/white line -> exit.
     (Calibration is stored inside the module, survives power-off.) */
  // (void)Track_SetAdjustMode(1u);
  // HAL_Delay(3000);
  // (void)Track_SetAdjustMode(0u);
  // HAL_Delay(500);
  /* USER CODE END 2 */

  /* Infinite loop */
  /* USER CODE BEGIN WHILE */
  while (1)
  {
    /* USER CODE END WHILE */

    /* USER CODE BEGIN 3 */
    /* Sample first, so the frame carries the freshest data:
       - LineFollow_Task: 循迹控制环 (算差速 -> 直接驱动两个电机)
       - Motor_TestTask: encoder accumulation + auto test sequence
       - MPU6050_Task  : IMU sampling (silent, no UART output) */
#if (MOTOR_SPIN_TEST == 1)
    MotorSpin_Task();     /* 调试模式: 两个轮子一直慢转 */
#else
    LineFollow_Task();    /* 正常模式: 循迹控制环驱动电机 */
#endif
    Motor_TestTask();
    MPU6050_Task();

    /* Single sender: builds and sends one unified $CAR frame on USART2 */
    Telemetry_Task();

    HAL_Delay(TELEMETRY_TASK_PERIOD_MS);
  }
  /* USER CODE END 3 */
}

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
