pekeppp/xunjicar-speed45/XunjiCar/XunjiCar/XunjiCar.ioc

Mcu.UserName=STM32F407VGTx
PA10.Signal=USART1_RX
PA13.Signal=SYS_JTMS-SWDIO
PA14.Signal=SYS_JTCK-SWCLK
PA2.Signal=USART2_TX
PA3.Signal=USART2_RX
PA6.Signal=S_TIM3_CH1
PA7.Signal=S_TIM3_CH2
PA8.Signal=I2C3_SCL
PA9.Signal=USART1_TX
PB10.Signal=I2C2_SCL
PB11.Signal=I2C2_SDA
PB6.Signal=I2C1_SCL
PB7.Signal=I2C1_SDA
PC6.Signal=S_TIM8_CH1
PC7.Signal=S_TIM8_CH2
PC9.Signal=I2C3_SDA
PD0.GPIO_Label=AIN1
PD0.Signal=GPIO_Output
PD1.GPIO_Label=AIN2
PD1.Signal=GPIO_Output
PD12.Signal=S_TIM4_CH1
PD13.Signal=S_TIM4_CH2
PD2.GPIO_Label=BIN1
PD2.Signal=GPIO_Output
PD3.GPIO_Label=BIN2
PD3.Signal=GPIO_Output
