pekeppp/xunjicar-speed45/XunjiCar/XunjiCar/Core/Inc/line_follow.h

/**
  ******************************************************************************
  * @file    line_follow.h
  * @brief   循迹控制环 + 激光测距避障 (参数全在这里, 调车只改这个文件)
  *
  * 数据来源:
  *   8 路循迹 -> track_uart.c (USART1)   bit7~bit0 = x1~x8, 1=白底, 0=压黑线
  *   激光测距 -> telemetry.c (VL53L0X)    D1 = I2C1, D2 = I2C3
  *               (受 LF_ENABLE_TOF_LASER 控制, 默认关)
  *   电机     -> motor_test.c             Motor_SetDuty(MOTOR_A/B, -100~+100)
  *
  * 控制思路 (最经典的"加权位置 + PD 差速"):
  *   1. 八个探头各给一个权重 w = {-35,-25,-15,-5,+5,+15,+25,+35} (x1 在最左)
  *   2. 只有压在黑线上的探头参与计算, 得到归一化位置 pos = -1000 ~ +1000
  *      pos < 0 表示线偏左, pos > 0 表示线偏右, 0 表示线在正中
  *   3. steer = (KP * pos + KD * (pos - 上次 pos)) / 1000   (单位: 占空比 %)
  *   4. 左轮 = 基础速度 + steer, 右轮 = 基础速度 - steer
  *      -> 线偏右(pos>0) 时 steer>0, 左轮加速右轮减速, 车头向右修正
  *   5. 激光测距小于 LF_STOP_DISTANCE_MM 就立刻停车, 障碍离开后自动恢复
  *      (整段避障还要 LF_ENABLE_TOF_LASER = 1 才生效, 默认是关的)
  *
  * 调参顺序 (详见《接线与调试手册》第 13 节):
  *   先只调 LF_BASE_DUTY 让它能走直 -> 再加 LF_KP 直到能过弯 ->
  *   最后加 LF_KD 压掉摆动 -> 都不行才考虑 LF_KI
  ******************************************************************************
  */

/* Define to prevent recursive inclusion -------------------------------------*/
#ifndef __LINE_FOLLOW_H__
#define __LINE_FOLLOW_H__

#ifdef __cplusplus
extern "C" {
#endif

/* Includes ------------------------------------------------------------------*/
#include "main.h"

/* ======================= 你要调的就是这一段 =============================== */

/** 1 = 上电 LF_START_DELAY_MS 之后自动开始循迹
  * 0 = 上电后一直停着, 需要自己调 LineFollow_SetEnable(1) 才动
  * (第一次试车建议先用 1, 但把车放在线上再上电; 想更安全就改 0 并自己加启动按钮) */
#define LF_AUTO_START            (1)

/** 上电后等多久开始跑 (ms): 给你时间把车放正、手拿开 */
#define LF_START_DELAY_MS        (1000u)

/* ---- 速度与转向 ---- */

/** 急弯自动降速: 这两个数决定"偏差多大时开始降速"和"最多降多少"
  * 直线和缓弯的偏差远到不了这里, 所以直道速度一点不变 (还是上面的 LF_BASE_DUTY)。
  * 起因 (见《接线与调试手册》14.8): 基础速度 45 时, 两轮 = 45 ± 差速,
  * 差速一超过 55 外轮就顶到 100% 被限幅了 —— 也就是说 90° 急弯缺的不是"差速上限",
  * 而是"外轮没有余量"。只降上限没用(上限 70→80 时外轮仍是 100%),
  * 把急弯那一下的基础速度压下来, 内轮能倒转到 -35%、外轮仍给满 100%, 转向才真的够。
  * 这两个值: 偏差 400 开始降, 到 900 降满 (45 - 12 = 33)。
  * 如果觉得急弯"降得不够/太多", 只改 LF_CORNER_SPEED_DROP (12 -> 15 更狠, -> 8 更轻) */
#define LF_CORNER_SLOW_POS       (400)   /**< 偏差超过它开始降速 */
#define LF_CORNER_SPEED_DROP     (12)    /**< 最多降这么多 % 的占空比 */

/** 直道基础速度 (%): 第一次试 25~30, 跑稳了再往上加
  * 40 -> 45: 手感调好之后整体提速一档 (+12.5%)。
  *   改速度要连带改 阻尼类 参数 (LF_KD / LF_KGYRO), 因为它们看的是"每秒变化多少":
  *   速度一快, 同样的偏差在 10 ms 里变化得更多, 阻尼必须按同样比例加大才等效。
  *   LF_KP 不用动 (KP 只放大偏差量, 与快慢无关), LF_STEER_LIMIT 也不用动
  *   (两轮的差速 = 速度 ± 上限, 上限占速度的比例基本没变)。
  *   ⚠ 提速的代价: ① 急弯更难 (同样半径需要更快的旋转) —— 已由下面的"急弯自动降速"处理
  *     ② 刹车距离变长 ③ 丢线容忍时间 LF_LOST_TIMEOUT_MS (350 ms) 对应的实际距离变长
  *     ④ 外轮更容易顶到 100%: 45 + 70 = 115 > 100, 最急的弯里外轮被限幅在 100% */
#define LF_BASE_DUTY             (45)

/** 比例系数: 线偏到最边上(满偏)时给多少 % 的差速
  * 车反应太肉/过弯冲出去 -> 加大; 车在线上来回猛摆 -> 减小
  * (提速到 45 时保持 45 不变: 速度更快 -> 相同时间偏得更多 -> PD 算出的修正率自动变大,
  *  等于本来就够用, 再加大反而会摆) */
#define LF_KP                    (45)

/** 微分系数: 压摆动用的. 摆得厉害就加大 (一般是 KP 的 1/4 ~ 1/2)
  * 12 -> 14: 配合 40 -> 45 的提速 (+12.5%) 同比加大, 保持原来的阻尼效果不变 */
#define LF_KD                    (14)

/** 积分系数: 一般保持 0, 只有"总是稳定偏向一侧"时才用一点点 */
#define LF_KI                    (0)

/** 差速上限 (%): 防止修正过猛把车甩出去
  * 50 -> 60 -> 70: 60~70 度的弯没问题, 但快 90 度的急弯"差点跑出线"。
  *   这一项同时决定"内轮能倒转到多少": 两轮 = 基础速度 ± 差速, 基础 45,
  *   所以上限 50 时内轮最好也只到 -5%(还在往前转), 70 时能到 -25%(真的在倒转) ——
  *   内轮倒转才拉得出最小转弯半径, 这是急弯能不能过的关键。
  *   上限只"封顶"、不放大: 直道那种小偏差算出来只有几个 %, 远够不到, 所以提高了也不影响
  *   你已经调好的直道和 60~70 度弯的手感。
  *   急弯还是转不过来就 70 -> 80; 如果直道上开始出现"一顿一顿"再退回 65。
  *   ⚠ 注意外轮也会被限幅: 两轮 = 45 ± 差速, 所以差速一旦超过 55, 外轮就顶到 100% 了。
  *     也就是说基础速度 45 时, "差速 70" 实际只能给出 100/45 的差速比, 而不是 115/45。
  *     内轮该倒转还是会倒转(-25%), 急弯主要靠这个; 真要拿满 70 的差速, 只能把速度降下来。
  *   (配合 line_follow.c 里的"急弯陀螺仪衰减": 偏差 >350 时阻尼自动降到 55%, 保证急弯的
  *    转向修正不被陀螺仪吃掉) */
#define LF_STEER_LIMIT           (70)

/** 控制周期 (ms): 一般不用改 */
#define LF_LOOP_PERIOD_MS        (10u)

/* ---- 探头极性 ---- */

/** 1 = 探头压在黑线上时该位是 0 (与 track_uart.h 的 TRACK_DATA_WHITE_IS_ONE=1 配套)
  * 如果实测"车往白的地方跑", 把这里改成 0 */
#define LF_BLACK_IS_ZERO         (1)

/* ---- 丢线处理 ---- */

/** 0 = 丢线就停车 (最安全, 先用它把参数调好)
  * 1 = 按丢线前的方向原地慢速找线
  * 2 = 用 MPU6050 保持航向, 沿丢线前的方向直行找线 (需要陀螺仪可用) */
#define LF_LOST_ACTION           (0)

/** 全白持续多久算丢线 (ms): 这段时间内按上次的修正量继续冲 */
#define LF_LOST_TIMEOUT_MS       (350u)

/** 找线时的速度 (%) */
#define LF_LOST_SEARCH_DUTY      (28)

/** LF_LOST_ACTION=2 时, 保持航向最多直行多久 (ms) */
#define LF_LOST_HOLD_MS          (800u)

/** 保持航向的纠正力度: 单位 0.1 %/度, 10 = 每偏 1 度给 1% 差速 */
#define LF_KHOLD                 (10)

/* ---- MPU6050 陀螺仪 (转向阻尼) ---- */

/** 1 = 用陀螺仪 Z 轴角速度做转向阻尼 (建议开, 能明显压掉画龙)
  * 0 = 不用. 没接 MPU 或没校准成功时这一项会自动失效, 不用改这里 */
#define LF_USE_IMU               (1)

/** 阻尼系数: 单位 0.01 %/dps, 10 = 每 1 dps 给 0.1% 差速
  * 转 200 dps 时约给 20% 差速. 摆得厉害就加大, 车发抖/发木就减小
  * 18 -> 20: ① 配合 40 -> 45 提速同比加大, 保持等效阻尼
  *           ② 之前"小角度走线轻微摆动"就是靠加大这一项压住的 (10 -> 18)
  *   回到 18 就退回提速前的等效手感; 还是摆就 22 -> 26 试; 车发木/跟不上弯就退到 16。
  *   前提: 遥测帧里 IMS=1 (陀螺仪有效), IMS=0 时这一项完全不生效 */
#define LF_KGYRO                 (20)

/** 陀螺仪方向: MPU6050 正面朝上时, 车往左转(逆时针俯视) GZ 为正 -> +1
  * 芯片倒扣安装, 或实测"加阻尼反而更晃", 就改成 -1 */
#define LF_GYRO_SIGN             (+1)

/** 1 = 八路全黑(横线/十字/全黑地面)时直行通过; 0 = 沿用上一次的位置 */
#define LF_ALL_BLACK_STRAIGHT    (1)

/* ---- 激光测距避障 ---- */

/** 激光测距总开关 (VL53L0X 的初始化 / 采样 / 前方避障 全归它管)
  * 0 = 关: 上电不初始化 VL53L0X、不占 I2C、遥测帧里也没有 D1/D2 两个字段,
  *         循迹控制环完全不做避障判断 —— 这是现在的默认值
  * 1 = 开: 恢复激光测距 + 前方避障 (下面的 LF_STOP_DISTANCE_MM 等参数才生效)
  * 关掉主要是为了避开两种情况: ① 模块误判把正常行驶的车刹停
  * ② 想省掉 I2C 初始化和每周期读距离的那点耗时
  * 想重新用激光避障就把这里改成 1, 重新编译烧录即可 */
#define LF_ENABLE_TOF_LASER      (0)

/** 前方距离小于这个值就停车 (mm); 填 0 = 关闭避障功能
  * (只有 LF_ENABLE_TOF_LASER = 1 时才会被编译进去) */
#define LF_STOP_DISTANCE_MM      (150u)

/** 障碍离开到多远才恢复行驶 (mm): 必须比上面大, 这是防抖动的迟滞 */
#define LF_RESUME_DISTANCE_MM    (220u)

/** 用哪一路 TOF 当前方: 0 = D1(I2C1), 1 = D2(I2C3), 2 = 两路取最近的那个
  * (填 0/1 时可以直接写下面的 LF_TOF_LEFT / LF_TOF_RIGHT, 比数字好认) */
#define LF_USE_FRONT_TOF         (2)

/* ---- 左右激光是哪一路 (已实测确认: D1 = 左边模块, D2 = 右边模块) ----
   总线归属是硬件定的, 没有歧义:
     路号 0 = 帧里的 D1 = I2C1 = PB6(SCL)/PB7(SDA) = TOF 1 号 = 装车后的【左边】模块
     路号 1 = 帧里的 D2 = I2C3 = PA8(SCL)/PC9(SDA) = TOF 2 号 = 装车后的【右边】模块
   下面两行就是上面这条实测结论的落地, 整个工程只有这一处定义左右语义,
   其它地方 (遥测帧 D1/D2、上位机显示、以后的左右分侧逻辑) 都引用它们.
   如果哪天把两个模块换个位置装, 就把下面两行对调 (LEFT 改 1、RIGHT 改 0),
   核对方法见《接线与调试手册》15.1: 挡左边那个模块, 变小的是左. */
#define LF_TOF_LEFT              (0)   /**< 左侧模块 → D1 / I2C1 */
#define LF_TOF_RIGHT             (1)   /**< 右侧模块 → D2 / I2C3 */

/* ======================= 下面一般不用改 =================================== */

/** 状态机 */
typedef enum
{
  LF_ST_IDLE = 0,   /**< 没使能 */
  LF_ST_WAIT,       /**< 使能了但还没数据 */
  LF_ST_RUN,        /**< 正常循迹 */
  LF_ST_COAST,      /**< 短暂丢线, 按上次修正量继续 */
  LF_ST_LOST,       /**< 确认丢线, 停车或找线 */
  LF_ST_BLOCKED     /**< 前方有障碍, 停车 */
} LineFollow_State_t;

/** 初始化 (上电调用一次, 必须在 Motor_Init 之后) */
void LineFollow_Init(void);

/** 主循环周期调用 (内部自己按 LF_LOOP_PERIOD_MS 限速, 非阻塞) */
void LineFollow_Task(void);

/** 开(1) / 关(0) 循迹; 关闭时立即停车 */
void LineFollow_SetEnable(uint8_t enable);

/** 当前是否使能 */
uint8_t LineFollow_IsEnabled(void);

/* 下面几个是给遥测帧用的 ------------------------------------------------ */

/** 当前状态名: IDLE/WAIT/RUN/COAST/LOST/BLOCK */
const char *LineFollow_GetStateName(void);

/** 归一化线位置 -1000(最左) ~ +1000(最右) */
int16_t LineFollow_GetPosition(void);

/** 当前差速修正量 (%) */
int16_t LineFollow_GetSteer(void);

/** 当前两轮输出占空比 (%) */
int16_t LineFollow_GetDuty(uint8_t motor);

/** 累计丢线次数 (看是不是经常丢线) */
uint32_t LineFollow_GetLostCount(void);

/** 本周期用到的 Z 轴角速度 (dps×10, 已扣零偏; 没数据时为 0) */
int16_t LineFollow_GetGyroDps10(void);

/** 丢线后相对"开始保持航向那一刻"转过的角度 (度×10, 左转为正) */
int16_t LineFollow_GetYawX10(void);

/** 陀螺仪数据当前是否有效 (没接 MPU / 没校准成功时为 0) */
uint8_t LineFollow_IsImuOk(void);

#ifdef __cplusplus
}
#endif

#endif /* __LINE_FOLLOW_H__ */
